erchivox/Prometheus-Team-2025/other/EncajeRuedaOneShape2026.jpeg

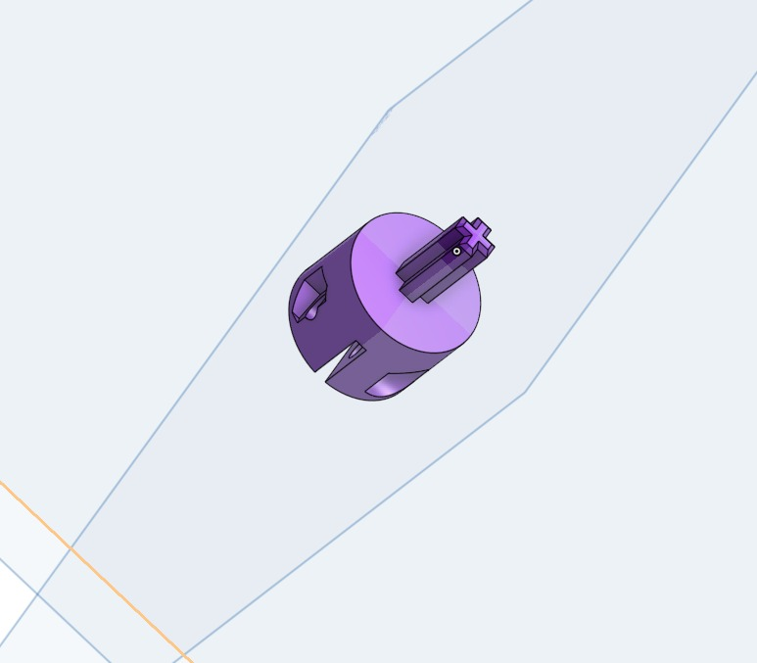
other/EncajeRuedaOneShape2026.jpeg
