erchivox/Prometheus-Team-2025/other/encajeSoporteTlfnOneShape2026.jpeg

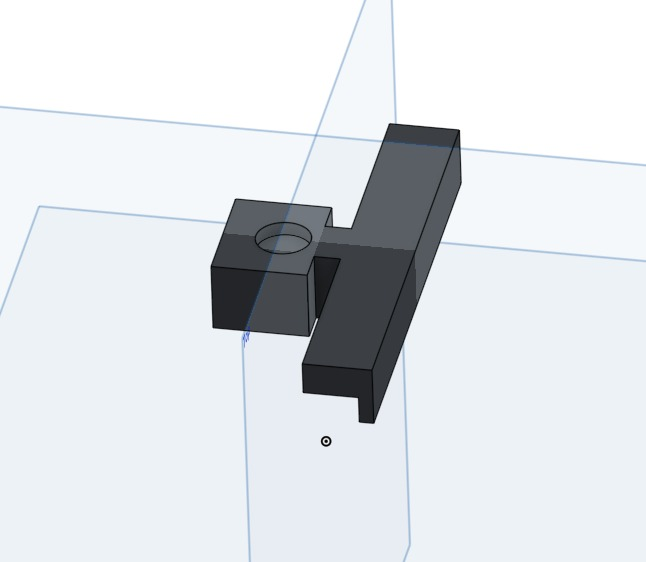
other/encajeSoporteTlfnOneShape2026.jpeg
