erchivox/Prometheus-Team-2025/other/engranajeMotorOneShape2026.jpeg

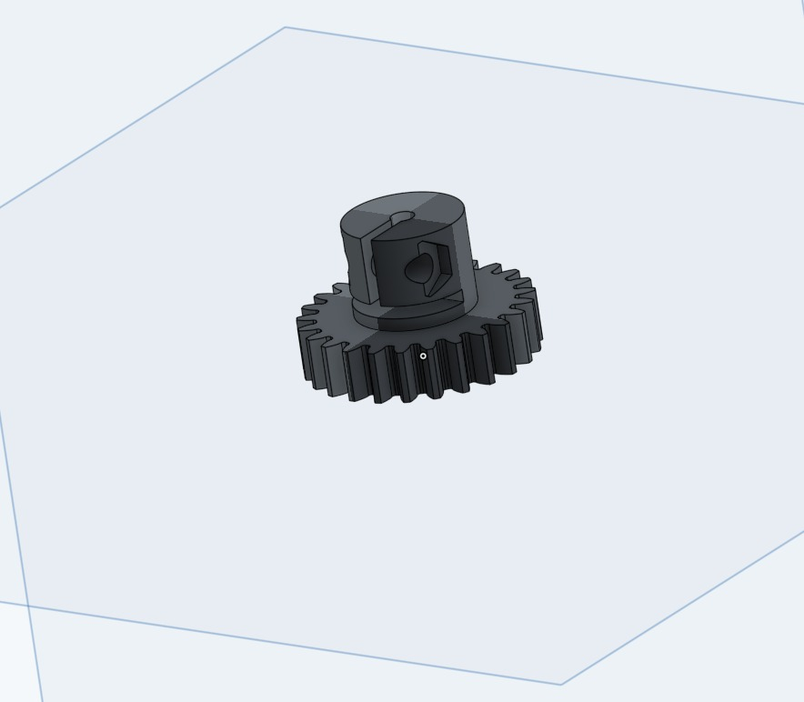
other/engranajeMotorOneShape2026.jpeg
