erchivox/Prometheus-Team-2025/other/engranajeVarillaOneShape2026.jpeg

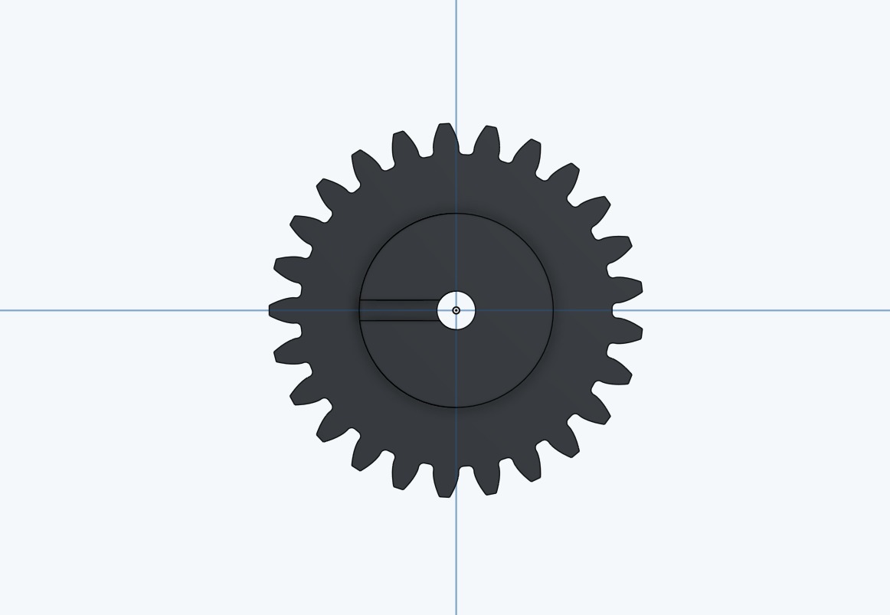
other/engranajeVarillaOneShape2026.jpeg
