erchivox/Prometheus-Team-2025/other/lateralSoporte2OneShape2026.jpeg

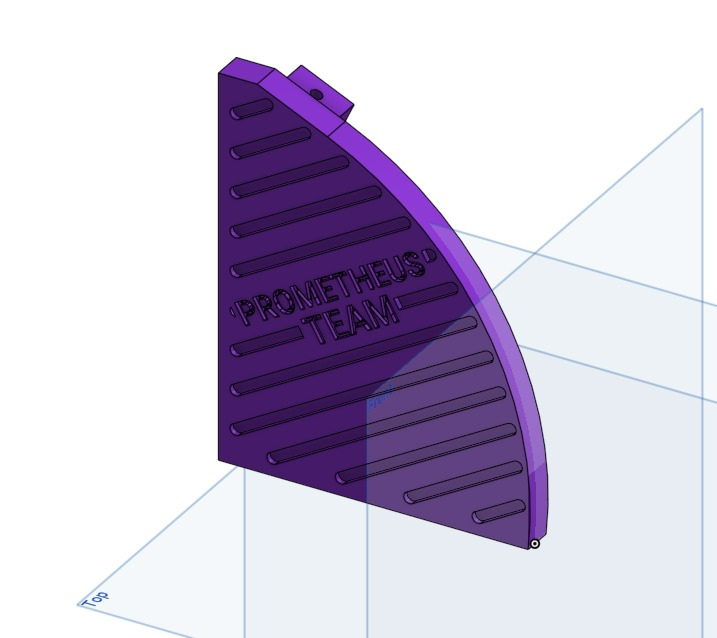
other/lateralSoporte2OneShape2026.jpeg
