erchivox/Prometheus-Team-2025/other/lateralSoporteTlfnOneShape2026.jpeg

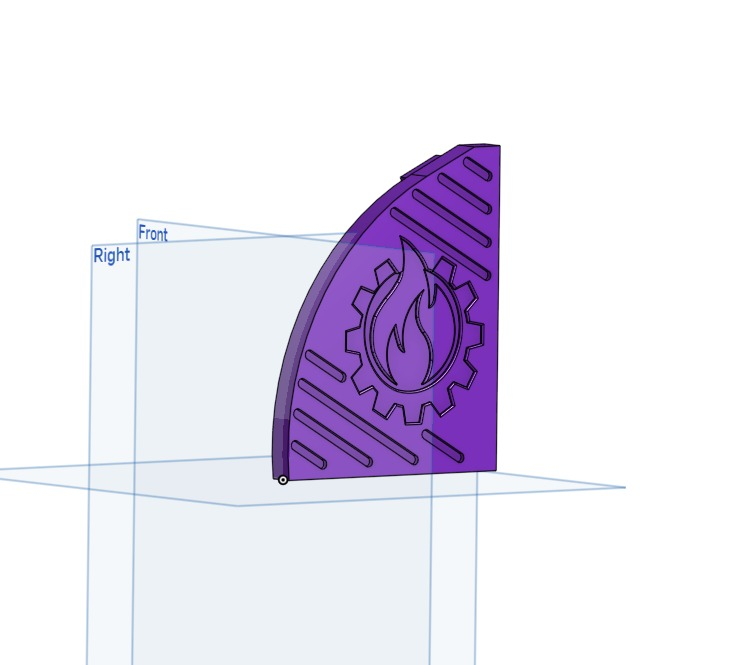
other/lateralSoporteTlfnOneShape2026.jpeg
