erchivox/Prometheus-Team-2025/other/motorConEngrenajesVistaCompletaOneShape2026.jpeg

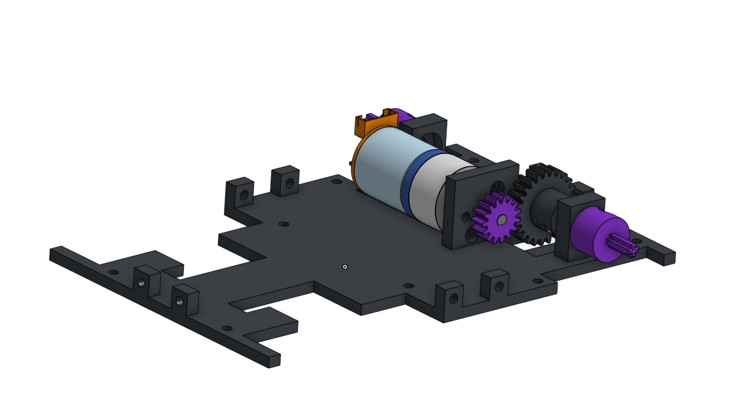
other/motorConEngrenajesVistaCompletaOneShape2026.jpeg
