erchivox/Prometheus-Team-2025/other/ShasisCompletoDiagonal2OneShape2026.jpeg

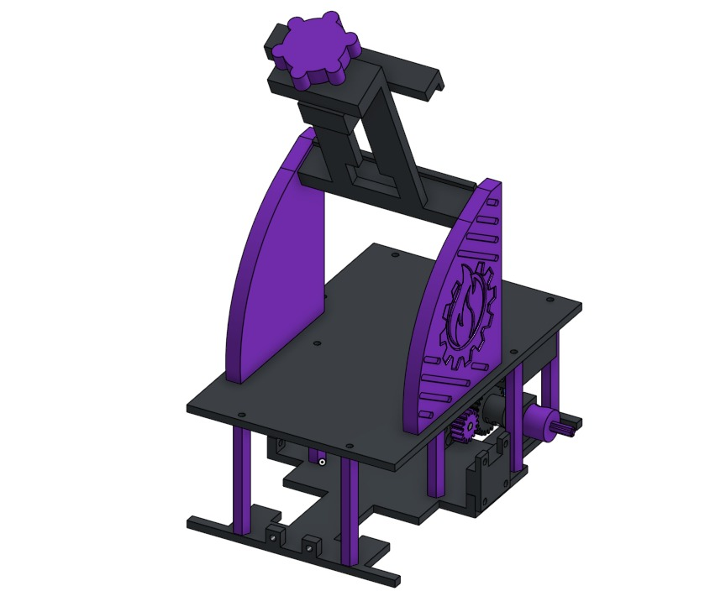
other/ShasisCompletoDiagonal2OneShape2026.jpeg
