erchivox/Prometheus-Team-2025/other/ShasisCompletodiagonalOneShape2026.jpeg

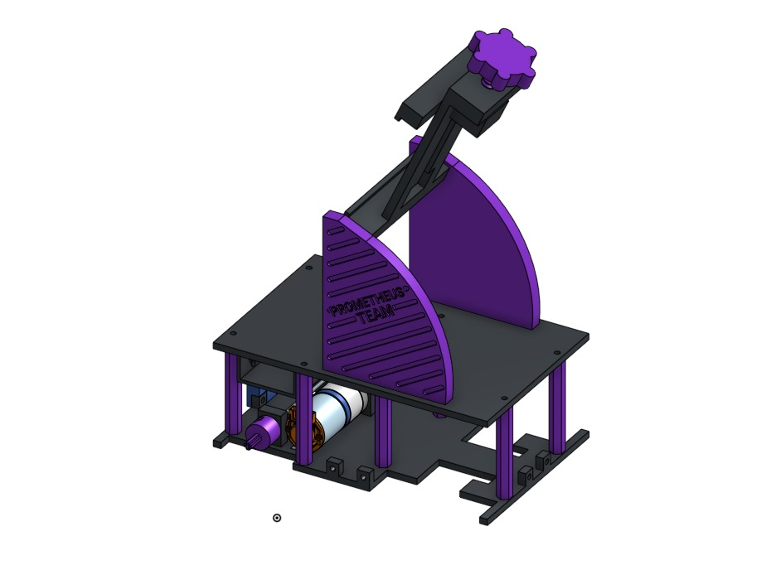
other/ShasisCompletodiagonalOneShape2026.jpeg
