erchivox/Prometheus-Team-2025/other/ShasisCompletoFrenteOneShape2026.jpeg

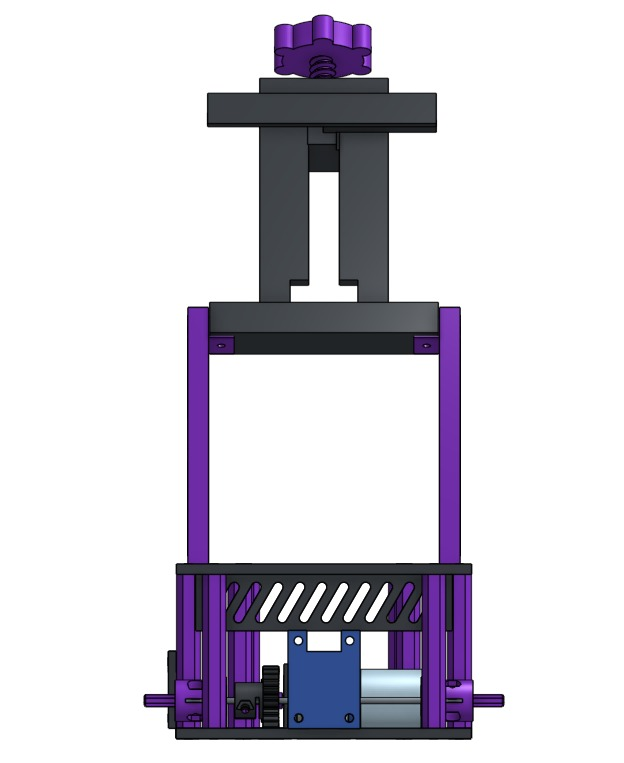
other/ShasisCompletoFrenteOneShape2026.jpeg
