erchivox/Prometheus-Team-2025/other/soporteSensorTofOneShape2026.jpeg

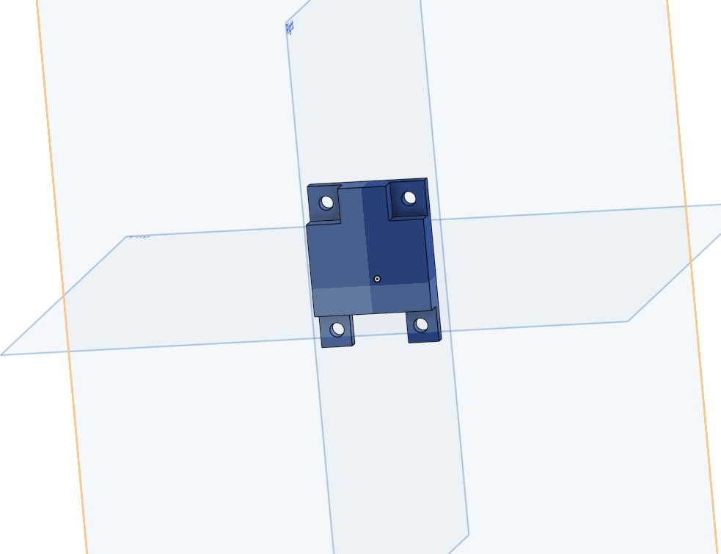
other/soporteSensorTofOneShape2026.jpeg
