erchivox/Prometheus-Team-2025/other/soporteTlfnOneShape2026.jpeg

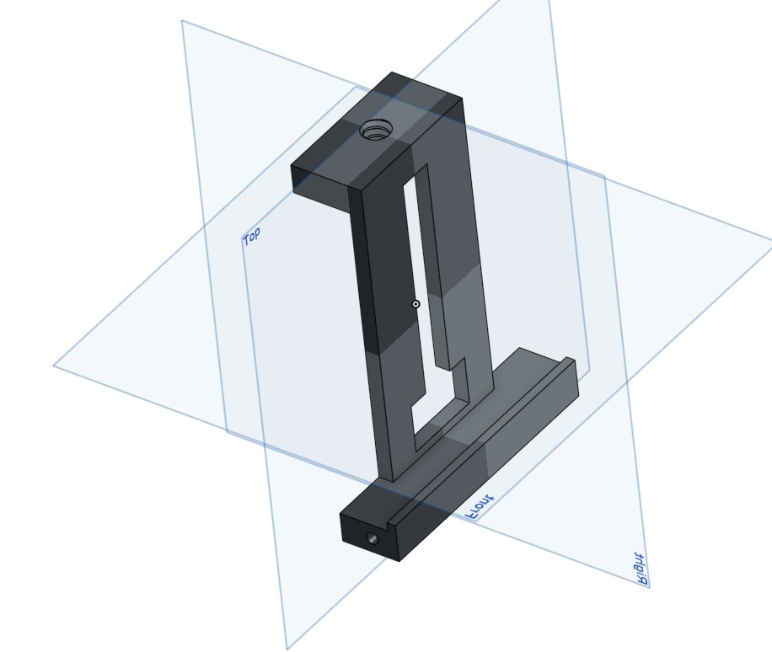
other/soporteTlfnOneShape2026.jpeg
