erchivox/Prometheus-Team-2025/other/soporteVarillaOneShape2026.jpeg

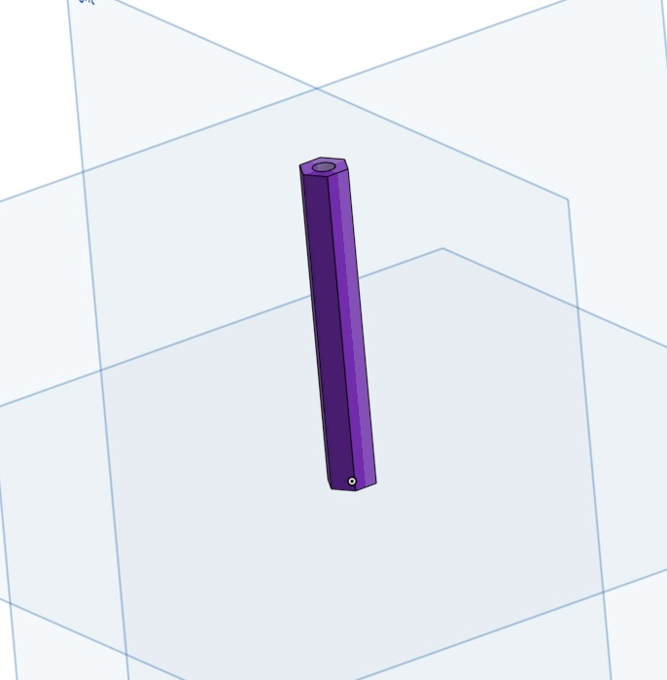
other/soporteVarillaOneShape2026.jpeg
