erchivox/Prometheus-Team-2025/other/tornilloTlfnOneShape2026.jpeg

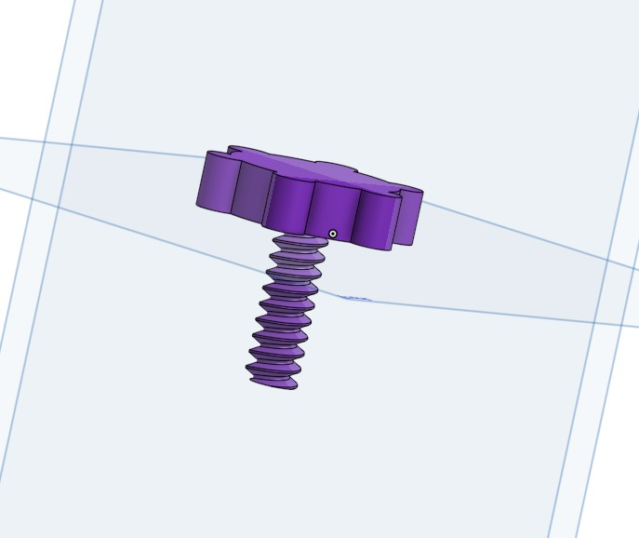
other/tornilloTlfnOneShape2026.jpeg
