erchivox/Prometheus-Team-2025/v-photos/ABAJO2026.jpeg

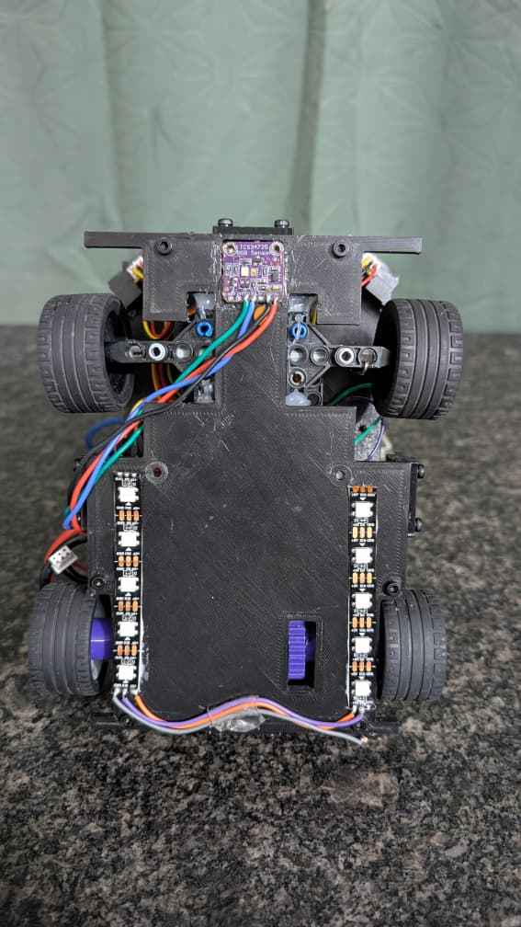
v-photos/ABAJO2026.jpeg
