erchivox/Prometheus-Team-2025/v-photos/ADELANTE2026.jpeg

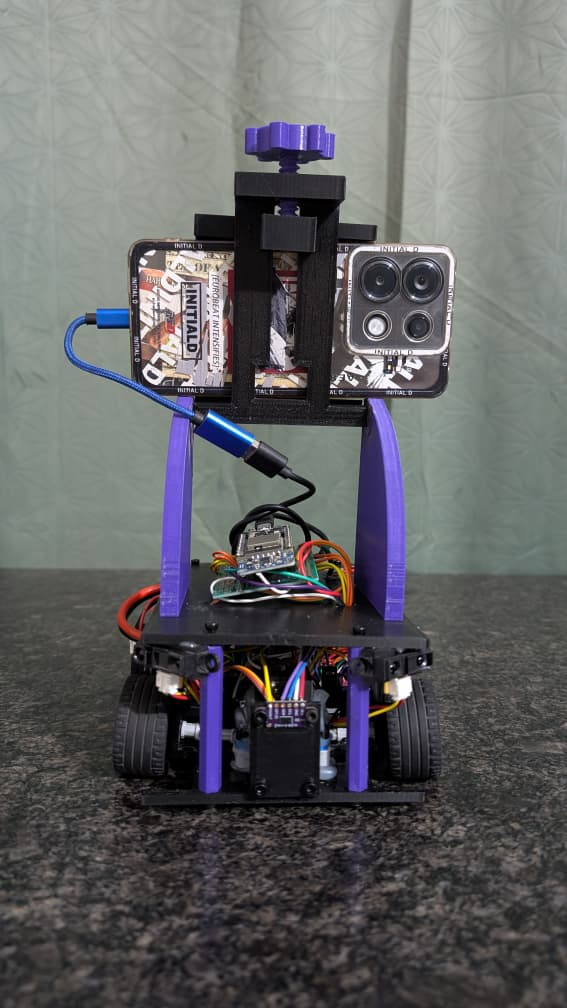
v-photos/ADELANTE2026.jpeg
