erchivox/Prometheus-Team-2025/v-photos/ARRIBA2026.jpeg

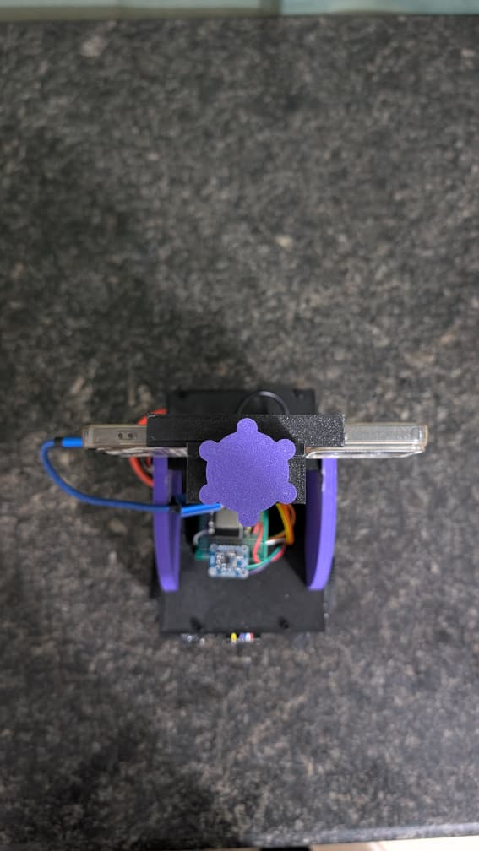
v-photos/ARRIBA2026.jpeg
