erchivox/Prometheus-Team-2025/v-photos/DERECHA2026.jpeg

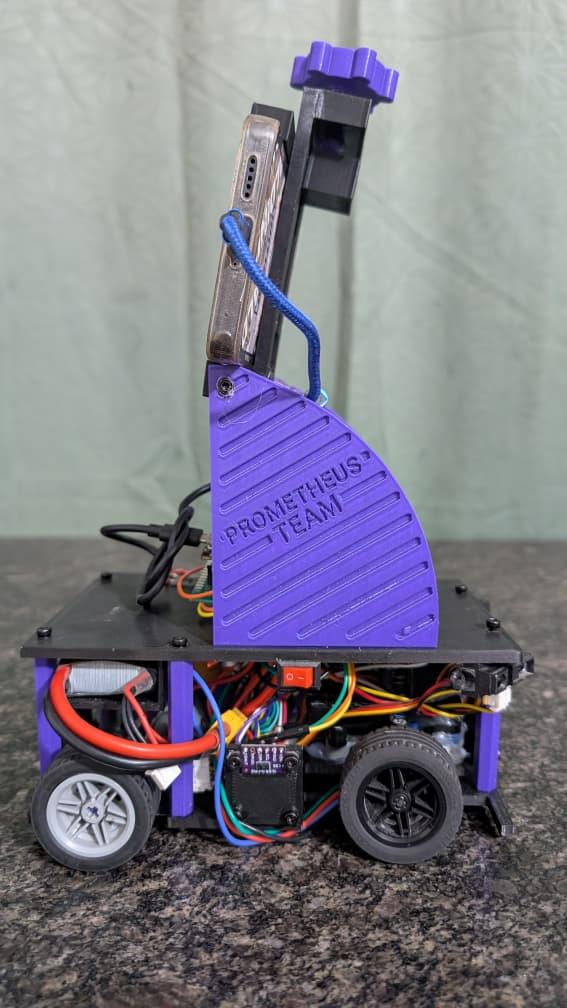
v-photos/DERECHA2026.jpeg
