erchivox/Prometheus-Team-2025/v-photos/DETRAS2026.jpeg

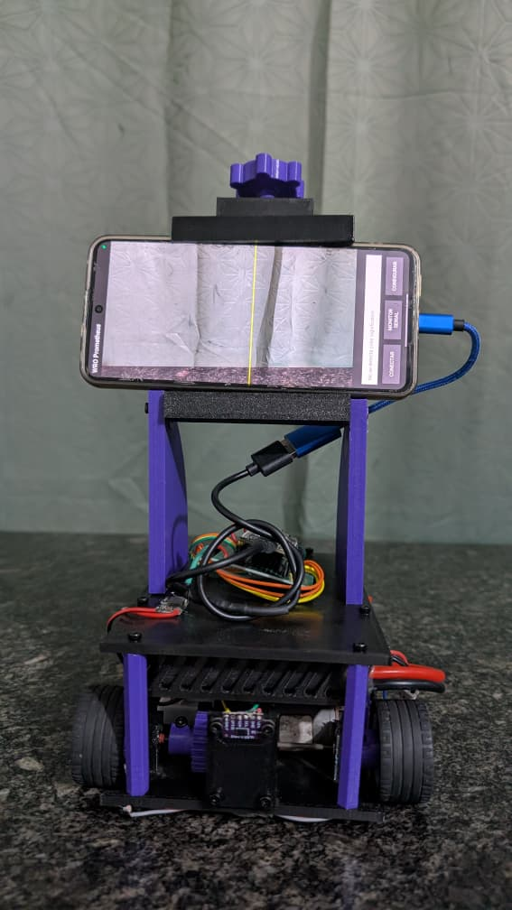
v-photos/DETRAS2026.jpeg
