erchivox/Prometheus-Team-2025/v-photos/IZQUIERDA2026.jpeg

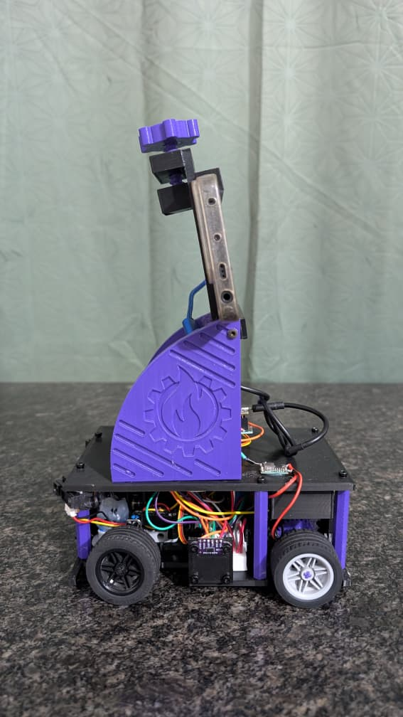
v-photos/IZQUIERDA2026.jpeg
