erchivox/Prometheus-Team-2025/src/v2PrometrusTeam2026.ino

//acuerdate que este codigo tiene 4 segundos para deteccion de una nueva linea
// advertencia : toma 2 tasas de cafe, guarda una copia de seguridad y cuidate del bug que solo pasa a las 
// 12pm, de resto suerte. 
#include <Wire.h>
#include <Adafruit_TCS34725.h>
#include <Adafruit_BNO055.h>

#include <ESP32Servo.h>
#include <ColorConverterLib.h>
#include <Adafruit_VL53L0X.h>
#include <Adafruit_Sensor.h>
#include <Adafruit_NeoPixel.h>

// --- Configuración de NeoPixels ---
#define NEOPIXEL_PIN 14   // ¡CÁMBIALO al pin de datos que vayas a usar!
#define NUMPIXELS 10       // ¡CÁMBIALO a la cantidad exacta de LEDs que tenga tu tira/módulo!

// Crear el objeto de la tira LED
Adafruit_NeoPixel tiraLED(NUMPIXELS, NEOPIXEL_PIN, NEO_GRB + NEO_KHZ800);

// --- Pines XSHUT para ToF ---
#define XSHUT_FRONTAL 17
#define XSHUT_TRASERO 16
#define XSHUT_IZQ     5
#define XSHUT_DER     18

Adafruit_TCS34725 tcs = Adafruit_TCS34725(TCS34725_INTEGRATIONTIME_2_4MS, TCS34725_GAIN_1X);
Adafruit_BNO055 bno = Adafruit_BNO055(55, 0x28, &Wire);
Servo direccion;

#define I2C2_SDA 32
#define I2C2_SCL 33
TwoWire I2CSegundo = TwoWire(1);

// --- Direcciones I2C ToF ---
#define ADDR_FRONTAL 0x30
#define ADDR_TRASERO 0x31
#define ADDR_IZQ     0x32
#define ADDR_DER     0x33

// --- Objetos ---
Adafruit_VL53L0X tofF = Adafruit_VL53L0X();
Adafruit_VL53L0X tofT = Adafruit_VL53L0X();
Adafruit_VL53L0X tofI = Adafruit_VL53L0X();
Adafruit_VL53L0X tofD = Adafruit_VL53L0X();

// --- Variables BNO055 ---
float yaw_offset = 0.0f;

// --- Configuración de Pines del Motor (Puente H) ---
const int MOTOR_IN1 = 27; // ¡Corregido! Estaba en conflicto con el pin 27 del interruptor
const int MOTOR_IN2 = 26; // Pin de dirección
const int MOTOR_ENA = 25; // Pin PWM para la velocidad

// --- Variables de Velocidad (rango de 0 a 255) ---
int velocidadBase = 255;      // Velocidad normal para avanzar
int velocidadRetroceso = 200; // Velocidad para echar hacia atrás
int velocidadLenta = 180;           // Velocidad reducida para avanzar 
int velocidadRetrocesoLento = 160;  // Velocidad reducida para retroceder

// --- Configuración de Canales PWM Independientes para ESP32 ---
const int canalMotor  = 4;
const int canalBuzzer = 5;
const int canalLED = 6;// Reservado por si quieres atenuar el LED luego

const int freqMotor = 1000;
const int resolucionPWM = 8;  // Resolución de 8 bits (0-255)

//const int MOTOR_RETROCESO_PIN = 19;  // Pin para motor de retroceso
//const int MOTOR_PIN = 15;
//const int MOTOR_RETROCESO_PIN_LENTO = 25;  // Pin para motor de retroceso
//const int MOTOR_PIN_LENTO = 26;
const int SERVO_PIN = 13;
// Declaraciones de pines (usar pines analógicos como digitales)
#define BUZZER_PIN  4  // Pin analógico A1 usado como digital para buzzer

// esta línea cerca del inicio del archivo, con las otras variables globales
bool primerGiroRealizado = false; // Flag para controlar el primer giro especial

//******************** colores 
// Variables para la detección del color azul
const int HUE_AZUL_MIN = 185;
const int HUE_AZUL_MAX = 240;
const float SATURACION_AZUL_MIN = 0.57;//0.40;
const float VALOR_AZUL_MIN = 0.40;
const float VALOR_AZUL_MAX = 0.80;
const float PROPORCION_AZUL_MIN = 1.1;//1.66
const int CONFIRMAR_AZUL_TOLERANCIA = 1;
const int CONFIRMAR_AZUL_DELAY = 1;
  
// Variables para la detección del color naranja
const int HUE_NARANJA_MIN = 2;//8;
const int HUE_NARANJA_MAX = 45;
const float SATURACION_NARANJA_MIN = 0.53;//40;
const float VALOR_NARANJA_MIN = 0.35;
const float VALOR_NARANJA_MAX = 0.72;
const int CONFIRMAR_NARANJA_TOLERANCIA = 1;
const int CONFIRMAR_NARANJA_DELAY = 1;
//*****888*******************************


const int INTERRUPTOR_PIN = 23;  // Pin digital para el interruptor (usa pin con interrupt)

// Variables de estado del sistema
bool sistemaIniciado = false;
bool interruptorAnterior = false;
unsigned long tiempoDebounce = 0;
const unsigned long DEBOUNCE_DELAY = 50;

// ===== CONFIGURACIÓN DE SERVO =====
const int SERVO_RIGHT = 0;
const int SERVO_CENTER = 90;
const int SERVO_LEFT  = 180;

const int SERVO_OrientadoObjeto_LEFT = 130;
const int SERVO_OrientadoObjeto_RIGH = 50;

const int SERVO_CENTRADO = SERVO_CENTER;

int contadorEntradaEstadoFinal = 0;

// Contador de líneas
int contadorLineas = 0;
int limiteLineas = 12;

int16_t ax, ay, az, gx, gy, gz;

float anguloZ = 0.0;
float pitch = 0.0;          // Ángulo Pitch (inclinación adelante/atrás)
float roll = 0.0;           // Ángulo Roll (inclinación lateral)

float anguloObjetivoGlobal = 0.0; // angulo recto para el giro


  float distanciaDerecha= 0 ;
    float distanciaIzquierda = 0 ;

const unsigned long TIEMPO_RETROCESO_MAXIMO = 1000;      // 1000Mayor tiempo para el giro más cerrado
const unsigned long TIEMPO_RETROCESO_ALTO = 0;        // 800Tiempo intermdio
const unsigned long TIEMPO_RETROCESO_MEDIO_ALTO = 0;  //600 Menor tiempo

// Ángulos de giro modificables para cada sentido
float giroObjetivoAzul = 70.0;    // Giro a la izquierda para línea azul
float giroObjetivoNaranja = 70.0; // Giro a la derecha para línea naranja (modificable)

float offsetGz = 0.0;
float offsetGx = 0.0; // Offset del giroscopio en X (Roll)
float offsetGy = 0.0; // Offset del giroscopio en Y (Pitch)

float umbralGiro = 1.0;
float umbralReposo = 0.5;
// Control de tiempo
unsigned long lastYawPrint = 0;
const unsigned long YAW_INTERVAL = 300;

unsigned long lastTime, startTime, timeoutGiro = 2000;


// ===== VARIABLES DE CONTROL DE DIRECCIÓN =====
bool corrigiendo = false;           // Estado de corrección activa
unsigned long tiempoInicioCorreccion = 0;
const unsigned long TIEMPO_MAX_CORRECCION = 6000; // 3 segundos máximo corrigiendo
const unsigned long TIEMPO_AVANCE_REINTENTO = 400; // 400ms de avance para reintentar
const unsigned long TIEMPO_ESTABILIZACION = 200;  // 200ms para estabilizar antes de verificar

float anguloObjetivo = 0.0;         // Ángulo objetivo dinámico
const float TOLERANCIA_ANGULO = 5.0; //4 antes Tolerancia de ±15° para considerar "recto"
const float TOLERANCIA_ANGULO_CORRECCION_LINEA_ANTES_DEL_GIRO = 15.0;
// ===== ESTADOS DE CORRECCIÓN =====
enum EstadoCorreccion {
  RECTO,                  // Vehículo va recto (0° ± margen)
  CORRIGIENDO_IZQUIERDA,  // Corrigiendo hacia la izquierda
  CORRIGIENDO_DERECHA,    // Corrigiendo hacia la derecha
  ESTABILIZANDO           // Estabilizando después de corrección
};

EstadoCorreccion estadoActualCorreccion = RECTO;
bool correccionCompletada = false;  // Flag para indicar que la corrección terminó

// Variables para control de centrado
bool enGiro = false;
unsigned long tiempoFinGiro = 0;
const unsigned long tiempoEsperaPosgiro = 0;
const int anguloCorreccionMax = 50;
const unsigned long intervaloCentrado = 100;
unsigned long ultimoTiempoCentrado = 0;

// Variables para pausar centrado durante detección
bool pausarCentrado = false;
unsigned long tiempoInicioDeteccion = 0;
const unsigned long tiempoPausaCentrado = 100;

// Variables para detección de líneas
bool lineaNaranjaDetectada = false;
unsigned long tiempoUltimaDeteccion = 0;
//tiempo de espera para deteccion de linea correcta, tambien se activa cuando inicia girando a carril.
const unsigned long tiempoEsperaDeteccion = 5000;//4000

// Flag para forzar tiempo de giro a 500ms al evadir obstáculo frontal
//Flag para controlar el inicio del cooldown tras un comando de carril
//bool iniciarCooldownCarril = false;

// Variables para direccionalidad
enum SentidoGiro {
  INDEFINIDO,
  IZQUIERDA,  // Detectó azul primero
  DERECHA     // Detectó naranja primero
};

SentidoGiro sentidoVehiculo = INDEFINIDO;
bool primeraDeteccion = true;

// ==================== VARIABLES PID PARA GIROS ====================

// Variables para controlador PID de giros
struct PIDController {
  float kp;           // Ganancia proporcional
  float ki;           // Ganancia integral
  float kd;           // Ganancia derivativa
  float error_anterior;
  float integral;
  float integral_max; // Límite para evitar windup
  unsigned long tiempo_anterior;
};

// Configuración del PID para giros
PIDController pidGiro = {
  .kp = 2.5,          // Ganancia proporcional - ajusta respuesta principal
  .ki = 0.8,          // Ganancia integral - elimina error en estado estacionario
  .kd = 0.4,          // Ganancia derivativa - reduce oscilaciones
  .error_anterior = 0,
  .integral = 0,
  .integral_max = 30, // Límite para integral windup
  .tiempo_anterior = 0
};

// Variables adicionales para control PID
float anguloObjetivoActual = 0;
bool giroEnProceso = false;
const float TOLERANCIA_PID = 5.0;      // Tolerancia más estricta con PID

// ==================== VARIABLES PID PARA CENTRADO ====================

// Variables para controlador PID de centrado
struct PIDCentrado {
  float kp;           // Ganancia proporcional
  float ki;           // Ganancia integral  
  float kd;           // Ganancia derivativa
  float error_anterior;
  float integral;
  float integral_max; // Límite para evitar windup
  unsigned long tiempo_anterior;
  bool inicializado;  // Para manejar primera ejecución
};

// Configuración del PID para centrado
PIDCentrado pidCentrado = {
  .kp = 2.0,          // Ganancia proporcional - respuesta principal al error
  .ki = 0.0,          // Ganancia integral - elimina error residual
  .kd = 1.2,          // Ganancia derivativa - reduce oscilaciones
  .error_anterior = 0,
  .integral = 0,
  .integral_max = 20, // Límite para integral windup
  .tiempo_anterior = 0,
  .inicializado = false
};

// Variables adicionales para control PID del centrado
const float TOLERANCIA_CENTRADO_PID = 5.0;    // Tolerancia más estricta
const float ERROR_MAXIMO_CENTRADO = 30.0;     // Error máximo esperado
const float FACTOR_SUAVIZADO = 0.7;           // Para suavizar cambios bruscos

// Buffer para comandos serie
String comandoRecibido = "";
  bool comandoListo = false;

// Pines para sensores de estacionamiento (el frontal ya está definido)
const int ULTRASONIDO_TRASERO_TRIG_PIN  = 18; // Pin para Trig del sensor ultrasónico trasero
const int ULTRASONIDO_TRASERO_ECHO_PIN = 35; // Pin para Echo del sensor ultrasónico trasero

//-------variables de evasion de objetos--------------

// Estados del sistema integrado
enum EstadoSistema {
  ESTADO_NORMAL,
  ESTADO_DETENCION_FINAL,
  ESPERANDO_COMANDO_CARRIL,
  EVALUANDO_POSICION,
  GIRANDO_HACIA_CARRIL,
  ENDEREZANDO_CARRIL,
  MANTENIENDO_CARRIL,
  ESTADO_CORRECCION_LATERAL 
};

// Variables para recepción serial optimizada (del código de esquive)
const int BUFFER_SIZE = 32;
char buffer[BUFFER_SIZE];
int bufferIndex = 0;

// Variables para parsing ultra rápido
char colorDetectado = 'N';
int distanciaObjeto = 0;
char orientacionObjeto = 'C';

// Variables de estado
EstadoSistema estadoActual = ESPERANDO_COMANDO_CARRIL;
char colorObjetivo = 'N';
unsigned long tiempoEsquive = 0;
int etapaEsquive = 0;
char lastOrientation = 'X';

// Configuración de distancias para esquive
const int DISTANCIA_ROJO = 35;//40;    // Distancia de esquive para objetos rojos
const int DISTANCIA_VERDE = 40;//45;   // Distancia de esquive para objetos verdes
const int DISTANCIA_EMERGENCIA = 8;
// Tiempos de esquive por color (en milisegundos)
const unsigned long TIEMPO_ESQUIVE_VERDE = 600;   // Tiempo para esquivar verde
const unsigned long TIEMPO_ESQUIVE_ROJO = 400;   // Tiempo para esquivar rojo
const unsigned long TIEMPO_RETORNO_VERDE = 600;   // Tiempo de retorno para verde
const unsigned long TIEMPO_RETORNO_ROJO = 600;    // Tiempo de retorno para rojo

// Variables para almacenar los tiempos actuales
unsigned long tiempoEsquiveActual = 0;
unsigned long tiempoRetornoActual = 0;

// Variables para recordar último color detectado
char ultimoColorDetectado = 'N';           // Último color válido recibido
unsigned long tiempoUltimoColor = 0;       // Timestamp del último color detectado
const unsigned long TIEMPO_MEMORIA_COLOR = 0; // 4 segundos de memoria

// Variables para función de emergencia
bool emergenciaActivada = false;
unsigned long tiempoUltimaEmergencia = 0;
const unsigned long TIEMPO_ESPERA_EMERGENCIA = 2000; // Evitar activaciones múltiples
char colorEmergencia = 'N';

// Variables para interrupción de cruce
volatile bool interrupcionCruce = false;
volatile char comandoInterrupcion = 'N';
bool cruceEnProceso = false;
//------------------- Fin de variables de esquive--------------

// ==================== CONFIGURACIÓN Y VARIABLES SHARP ====================

// Pines para sensores Sharp diagonales
const int SHARP_DIAGONAL_IZQ_PIN = 35;  // Pin analógico para sensor Sharp izquierdo
const int SHARP_DIAGONAL_DER_PIN = 34;  // Pin analógico para sensor Sharp derecho

const float DISTANCIA_EMERGENCIA_SHARP_PARED = 13.0; // Distancia en cm para activar el retroceso de emergencia
const unsigned long TIEMPO_RETROCESO_SHARP_PARED = 700;  //800 Tiempo de retroceso en ms (ajustable)

 //CONSTANTES PARA CORRECCIÓN EN PARED *****
const float DISTANCIA_MINIMA_SHARP_PARED = 12.0; // Distancia en cm para activar la corrección
const int ANGULO_CORRECCION_SHARP_IZQ = 180;     // Ángulo para girar a la izquierda (alejarse de la pared derecha)
const int ANGULO_CORRECCION_SHARP_DER = 0;      // Ángulo para girar a la derecha (alejarse de la pared izquierda)
unsigned long tiempoUltimaEmergenciaSharpDer = 0;
unsigned long tiempoUltimaEmergenciaSharpIzq = 0;
const unsigned long COOLDOWN_EMERGENCIA_SHARP = 2000; // 3 segundos para considerar una detección como "reciente"
const unsigned long DURACION_AVANCE_CORRECTIVO = 800; // 400ms de avance

// Variables para esquive diagonal por sensores Sharp
bool esquiveDiagonalActivo = false;
unsigned long tiempoInicioEsquiveDiagonal = 0;
unsigned long tiempoUltimaDeteccionSharp = 0;
char direccionEsquiveDiagonal = 'N'; // 'I' = izquierda, 'D' = derecha
int etapaEsquiveDiagonal = 0;

// Configuración para sensores Sharp diagonales
const float DISTANCIA_SHARP_EMERGENCIA = 15.0;     // 10cm de detección
const unsigned long TIEMPO_CRUCE_DIAGONAL = 500;  // Tiempo de cruce diagonal
const unsigned long TIEMPO_ESPERA_SHARP = 100;     // Evitar detecciones múltiples

// Sistema de prioridades para gestión de emergencias
enum PrioridadEmergencia {
  PRIORIDAD_NORMAL,
  PRIORIDAD_RETROCESO,  // Máxima prioridad
  PRIORIDAD_ESQUIVE     // Prioridad normal
};
PrioridadEmergencia prioridadActual = PRIORIDAD_NORMAL;

// Variables mejoradas para retroceso de emergencia
const int DISTANCIA_RETROCESO_EMERGENCIA = 10;    // Distancia mínima para activar retroceso (cm)
const unsigned long TIEMPO_RETROCESO = 2000;     // Tiempo de retroceso en ms
const unsigned long TIMEOUT_RETROCESO = 2500;    // Timeout de seguridad para retroceso
bool retrocesoPorEmergencia = false;    
// Variables de control temporal
unsigned long tiempoInicioRetroceso = 0;          
unsigned long tiempoUltimaVerificacionRetroceso = 0; 
const unsigned long INTERVALO_VERIFICACION_RETROCESO = 100; // Verificación cada 100ms
const unsigned long TIEMPO_ESPERA_POST_RETROCESO = 100;     // Tiempo de espera después del retroceso
bool motorRetrocesoConfigurado = false;  // controlar configuración de motores

bool retrocesoOrientadoActivo = false;
bool enFaseContragiro = false; // true cuando está ejecutando el contragiro de enderezado
bool omitioGiro = false; // true cuando saltó directo a MANTENIENDO sin hacer giro
unsigned long tiempoInicioRetrocesoOrientado = 0;
const unsigned long TIEMPO_RETROCESO_ORIENTADO = 700; // 1 segundo (modificable)
int direccionRetroceso = SERVO_CENTRADO;

// ==================== ESTRUCTURA DE CONTROL LATERAL ====================
struct ControlDistanciaLateral {
  enum Estado {
    IDLE,
    MOVIENDO_DERECHA,
    MOVIENDO_IZQUIERDA,
    CORRIGIENDO_ANGULO_DERECHA,
    CORRIGIENDO_ANGULO_IZQUIERDA,
    RETROCEDIENDO_ORIENTADO,     
    CORRIGIENDO_POST_RETROCESO,   
    RETROCEDIENDO_FINAL
    };     
  Estado estadoActual = IDLE;
  unsigned long tiempoInicioEstado = 0;
  float anguloObjetivo = 0.0;
  bool funcionActiva = false; 
  unsigned long ultimaVerificacion = 0;
  bool esCorreccionLarga = false; //  Flag para saber qué maniobra ejecutar
  char direccionManiobra = 'N';   // 'D' o 'I' para recordar la dirección

  // Parámetros de control
  const float UMBRAL_MIN = 30.0;//38
  const float UMBRAL_MAX = 55.0; 
  unsigned long tiempoCruceActual = 1000;
  
  const float DISTANCIA_TRASERA_OBJETIVO = 15.0; // cm
  const float TOLERANCIA_ANGULAR = 2.0; 
  const unsigned long INTERVALO_VERIFICACION = 1000;
};

ControlDistanciaLateral controlLateral_PostGiro; // Usamos un nuevo nombre para no confundir con el existente

// Variables para control de retroceso post-giro
unsigned long tiempoInicioEvaluacion = 0;
// ============== CONSTANTES DE ÁNGULOS ==============
const float GIRO_MAXIMO = 70.0;      // Giro máximo - obstáculo muy cerca
const float GIRO_ALTO = 60.0;        // Giro alto - obstáculo cerca
const float GIRO_MEDIO_ALTO = 50.0;  // Giro medio-alto
const float GIRO_MEDIO = 50.0;       // Giro medio
const float GIRO_MEDIO_BAJO = 50.0;  // Giro medio-bajo
const float GIRO_BAJO = 50.0;        // Giro bajo - obstáculo lejano
const float GIRO_MINIMO = 60.0;//30.0 Giro mínimo - obstáculo muy lejano
float anguloObjetivoGiroGlobal = 0;
// Variable para distancia mínima para terminar el retroceso post giro
float DISTANCIA_MINIMA_RETROCESO = 15.0; // 15cm
const unsigned long TIMEOUT_RETROCESO_MAXIMO = 4000;    // Timeout de seguridad de retroceso orientado
// Variable global para medir tiempo de retroceso durante corrección
unsigned long tiempoTotalRetroceso = 0;
bool huboRetrocesoEnCorreccion = false;

// Variables para el giro de apertura
bool giroAperturaActivo = false;
bool giroAperturaCompletado = false;
unsigned long tiempoInicioApertura = 0;
const unsigned long DURACION_APERTURA_MINIMO = 200;//500     // Tiempo para el giro más suave
const unsigned long DURACION_APERTURA_BAJO = 0;   //200    // tiempo, más corto
const unsigned long DURACION_APERTURA_MEDIO_BAJO = 0; //  tiempo, el más corto
bool esGiroApertura = false;
unsigned long duracionAperturaActual = DURACION_APERTURA_MINIMO; // Variable para almacenar la duración del giro actualbool esGiroApertura = false;
bool direccionGiroAperturaIzquierda = false;

bool sistemaActivo = false;  // Estado del sistema (activo/inactivo)

// Variable para controlar giro antes de estacionamiento
bool giroParaEstacionamiento = false;

// tiempo de finalizacion del codigo para avance final
unsigned long tiempoInicio = millis();
//unsigned long duracionCiclo = 3000; // 5 segundos en milisegundos

unsigned long tiempoInicioDetencionFinal = 0;


// Variables globales para el control de arranque del motor
unsigned long tiempoInicioSistema = 0;
bool motorArrancado = false;
const unsigned long DELAY_ARRANQUE_MOTOR = 1000; // 1 segundo en milisegundos

static unsigned long tiempoInicioAvance = 0;

// Variable para pausa de prueba (configurable)
static unsigned long tiempoInicioPausa = 0;

// Configuración para control angular prioritario
#define UMBRAL_ANGULO_MAX 15.0      // Umbral máximo de desviación angular (±20°)
#define TOLERANCIA_ANGULO_FINO 2.0  // Tolerancia para considerar ángulo correcto
#define FACTOR_CORRECCION_ANGULAR 0.8  // Factor fuerte para corrección angular
#define FACTOR_CORRECCION_DISTANCIA 0.3  // Factor menor para distancia cuando hay error angular


// ==================== CONFIGURACIÓN DEL SISTEMA DE CARRILES ====================
struct SistemaCarriles {
  // Definición de carriles
  float distanciaCarril1;
  float distanciaCarril2;  
  float toleranciaCarril;
  float umbralCambio;
  
  // Parámetros de control
  float velocidadGiro;
  unsigned long tiempoGiro;
  unsigned long tiempoGiroCarril1;
  unsigned long tiempoGiroCarril2;
  float toleranciaAngulo;
  
  // Variables de control
  int carrilObjetivo;
  char ladoControl;
  unsigned long tiempoInicioEstado;
  float direccionGiro;
  bool necesitaCambio;
  bool esComandoC21;
  bool esComandoC14; 
  bool esComandoC15;
  bool esComandoC20;
  bool esComandoC26; 
  bool esComandoC33;
  bool esComandoC27;
  bool esComandoC32;

  bool esComandoC36;

  //individuales
  bool esComandoC02;
  bool esComandoC08;

  bool esComandoC07;
  bool esComandoC01;
    bool esComandoC01ModoDistancia; // C01 con sentido IZQUIERDA: tiempo de giro variable por ToF derecho
    bool esComandoC07ModoDistancia;
    bool esComandoC02ModoDistancia;
    bool esComandoC08ModoDistancia;
  
};

SistemaCarriles carriles = {
  .distanciaCarril1 = 20.0,
  .distanciaCarril2 = 20.0,
  .toleranciaCarril = 3.0,
  .umbralCambio = 1.0,
  .velocidadGiro = 45.0,
  .tiempoGiro = 1500,
  .tiempoGiroCarril1 = 1400,//1800
  .tiempoGiroCarril2 = 1300,//1500
  .toleranciaAngulo = 5.0,
  .carrilObjetivo = 0,
  .ladoControl = 'D',
  .tiempoInicioEstado = 0,
  .direccionGiro = 0,
  .necesitaCambio = false,
  .esComandoC21 = false,
  .esComandoC14 = false,
  .esComandoC15 = false,
  .esComandoC20 = false,
  .esComandoC26 = false,
  .esComandoC33 = false,
  .esComandoC27 = false,
  .esComandoC32 = false,
  .esComandoC36 = false,

  //individuales
  .esComandoC02 = false,
  .esComandoC08 = false,

  .esComandoC07 = false,
  .esComandoC01 = false,
    .esComandoC01ModoDistancia = false,
    .esComandoC07ModoDistancia = false,
    .esComandoC02ModoDistancia = false,
    .esComandoC08ModoDistancia = false


  
};
int ultimoCarrilActivo = 0; 
// Variables de tiempo y monitoreo de carriles
unsigned long ultimaActualizacion = 0;
const unsigned long INTERVALO_CONTROL = 50;
unsigned long ultimoReporte = 0;
const unsigned long INTERVALO_REPORTE = 300;


const unsigned long INTERVALO_maxAngulo = 500;  // 2000 ms = 2 segundos

unsigned long ultimaImpresion_maxAngulo = 0;

// Estructura para el control lateral
struct FiltroDistancia {
  float historial[5];
  int indice;
  bool inicializado;
  float ultimaDistanciaValida;
  float umbralCambioMaximo;
  
  void inicializar() {
    for (int i = 0; i < 5; i++) historial[i] = 0;
    indice = 0;
    inicializado = false;
    ultimaDistanciaValida = 0;
    umbralCambioMaximo = 50.0;
  }
  
  float filtrar(float nuevaLectura) {
    if (nuevaLectura <= 0 || nuevaLectura > 150) {
      return ultimaDistanciaValida;
    }
    if (!inicializado || abs(nuevaLectura - ultimaDistanciaValida) <= umbralCambioMaximo) {
      historial[indice] = nuevaLectura;
      indice = (indice + 1) % 5;
      if (!inicializado) {
        for (int i = 0; i < 5; i++) historial[i] = nuevaLectura;
        inicializado = true;
      }
      float suma = 0;
      for (int i = 0; i < 5; i++) suma += historial[i];
      ultimaDistanciaValida = suma / 5.0;
      return ultimaDistanciaValida;
    } else {
      return ultimaDistanciaValida;
    }
  }
};

struct ControlLateral {
  float distanciaObjetivo;
  float toleranciaDistancia;
  float toleranciaAngulo;
  float anguloObjetivo;
  float anguloUmbral;
  float kpDistancia, kiDistancia, kdDistancia;
  float correccionMaxima;
  float factorGiroIzquierda;
  float factorGiroDerecha; 
  float errorDistanciaAnterior;
  float integralDistancia;
  float integralMaxDistancia;
  char ladoControl;
  FiltroDistancia filtroIzquierda;
  FiltroDistancia filtroDerecha;
};

ControlLateral controlLateral = {
  .toleranciaDistancia = 3.0,
  .toleranciaAngulo = 3.0,//algulo aceptado como recto
  .anguloObjetivo = 0.0,
  .anguloUmbral = 20.0, //angulo de desviasion maxima para empezar correccion agresiva
  .kpDistancia = 4.0,
  .kiDistancia = 0.0,
  .kdDistancia = 1.2,
  .correccionMaxima = 40.0,
  .factorGiroIzquierda = 0.8,//1.0
  .factorGiroDerecha = 0.8,
  .errorDistanciaAnterior = 0,
  .integralDistancia = 0,
  .integralMaxDistancia = 20.0,
  .ladoControl = 'D'
};
unsigned long ultimaActualizacionf = 0;
const unsigned long INTERVALO_CONTROLf = 50;
unsigned long ultimoReportef = 0; // Añade esta línea
const unsigned long INTERVALO_REPORTEf = 300; // Añade esta línea (imprime ~3 veces/seg)

// --- Configuración de Tareas Multi-núcleo (FreeRTOS) ---

TaskHandle_t TareaColorHandle = NULL;



// ==================== TEMPORIZADOR NO BLOQUEANTE PARA LEDS ====================
unsigned long tiempoInicioLedTemporal = 0;
unsigned long duracionLedTemporal = 0;
bool ledTemporalActivo = false;

// Tiempo mínimo que el vehículo avanza en MANTENIENDO_CARRIL antes del cambio C21
const unsigned long TIEMPO_AVANCE_MANTENIENDO_C21 = 500; // ms — ajustable
const unsigned long TIEMPO_AVANCE_MANTENIENDO_C14 = 100; // ms — ajustable
const unsigned long TIEMPO_AVANCE_MANTENIENDO_C15 = 800; // ms — ajustable
const unsigned long TIEMPO_AVANCE_MANTENIENDO_C20 = 700; // ms — ajustable

const unsigned long TIEMPO_AVANCE_MANTENIENDO_C26 = 0; // rojo derecha, verde derecha

const unsigned long TIEMPO_AVANCE_MANTENIENDO_C27 = 500; // rojo derecha, verde derecha

const unsigned long TIEMPO_AVANCE_MANTENIENDO_C32 = 200; // rojo derecha, verde derecha
const unsigned long TIEMPO_AVANCE_MANTENIENDO_C33 = 200; // rojo derecha, verde derecha

// Función para lanzar un destello sin bloquear el código
void encenderLedTemporal(uint8_t r, uint8_t g, uint8_t b, unsigned long duracion) {
  colorVehiculo(r, g, b);
  tiempoInicioLedTemporal = millis();
  duracionLedTemporal = duracion;
  ledTemporalActivo = true;
}

// Función que vigila si ya es hora de apagar el destello
void actualizarLedTemporal() {
  if (ledTemporalActivo && (millis() - tiempoInicioLedTemporal >= duracionLedTemporal)) {
    // Si estamos en modo de espera, debe volver a morado. Si no, se apaga.
    if (estadoActual == ESPERANDO_COMANDO_CARRIL) {
      colorVehiculo(128, 0, 255); // Morado
    } else {
      apagarVehiculo();
    }
    ledTemporalActivo = false;
  }
}
// ==============================================================================
// ==================== CONTROL DE NEOPIXELS ====================
// Función para poner todos los LEDs del mismo color de golpe
void colorVehiculo(uint8_t r, uint8_t g, uint8_t b) {
  for(int i = 0; i < tiraLED.numPixels(); i++) {
    tiraLED.setPixelColor(i, tiraLED.Color(r, g, b));
  }
  tiraLED.show();
}

// Función para apagar los LEDs
void apagarVehiculo() {
  tiraLED.clear();
  tiraLED.show();
}
// ==============================================================

// Función independiente que se ejecuta continuamente en el Núcleo 0
void TareaDeteccionColor(void * pvParameters) {
  Serial.print(F("Control del sensor de color iniciado en el núcleo: "));
  Serial.println(xPortGetCoreID());

  while (1) {
    // Ejecuta la lectura del sensor solo si el interruptor activó el sistema
    if (sistemaActivo) {
      detectarColor();
    }
    

    vTaskDelay(pdMS_TO_TICKS(30)); 
  }
}

// ==================== FUNCIONES DE CONTROL DE MOTOR ====================
void detenerMotor() {
  digitalWrite(MOTOR_IN1, LOW);
  digitalWrite(MOTOR_IN2, LOW);
  ledcWrite(MOTOR_ENA, 0); // <-- Cambiado canalMotor por MOTOR_ENA
}

void avanzarMotor(int velocidad = velocidadBase) {
  digitalWrite(MOTOR_IN1, HIGH);
  digitalWrite(MOTOR_IN2, LOW);
  ledcWrite(MOTOR_ENA, velocidad); // <-- Cambiado canalMotor por MOTOR_ENA
}

void retrocederMotor(int velocidad = velocidadRetroceso) {
   digitalWrite(MOTOR_IN1, LOW);
  digitalWrite(MOTOR_IN2, HIGH); 
  ledcWrite(MOTOR_ENA, velocidad); // <-- Cambiado canalMotor por MOTOR_ENA
}


void avanzarLento() {
  // Reutiliza la lógica de avanzar, pero le inyecta la velocidad reducida
  avanzarMotor(velocidadLenta); 
}

void retrocederLento() {
  // Reutiliza la lógica de retroceder, pero le inyecta la velocidad reducida
  retrocederMotor(velocidadRetrocesoLento); 
}
// =======================================================================
float leerToF(char sensor) {
  VL53L0X_RangingMeasurementData_t measure;
  switch(sensor) {
    case 'F': tofF.rangingTest(&measure, false); break;
    case 'T': tofT.rangingTest(&measure, false); break;
    case 'I': tofI.rangingTest(&measure, false); break;
    case 'D': tofD.rangingTest(&measure, false); break;
    default: return 999.0;
  }
  if (measure.RangeStatus != 4) {
    return measure.RangeMilliMeter / 10.0;
  } else {
    return 999.0;
  }
}


// ==================== FUNCIONES DE CARRIL ====================
float obtenerDistanciaObjetivo() {
  if (carriles.carrilObjetivo == 1) {
    return carriles.distanciaCarril1;
  } else {
    return carriles.distanciaCarril2;
  }
}

char obtenerLadoControlPorCarril() {
  if (carriles.carrilObjetivo == 1) {
    return 'D';  // Carril 1 siempre usa sensor derecho
  } else {
    return 'I';  // Carril 2 siempre usa sensor izquierdo
  }
}

String obtenerNombreEstado(EstadoSistema estado) { // 1. Cambiado el tipo de parámetro
  switch (estado) {
    // Estados generales
    case ESTADO_NORMAL: return "ESTADO_NORMAL";
    case ESTADO_DETENCION_FINAL: return "ESTADO_DETENCION_FINAL";
    
    // Estados de carril (usando los nombres de EstadoSistema)
    case ESPERANDO_COMANDO_CARRIL: return "ESPERANDO_COMANDO_CARRIL";
    case EVALUANDO_POSICION: return "EVALUANDO_POSICION";
    case GIRANDO_HACIA_CARRIL: return "GIRANDO_HACIA_CARRIL";
    case ENDEREZANDO_CARRIL: return "ENDEREZANDO_CARRIL";
    case MANTENIENDO_CARRIL: return "MANTENIENDO_CARRIL";
    case ESTADO_CORRECCION_LATERAL: return "ESTADO_CORRECCION_LATERAL"; 
    
    default: return "DESCONOCIDO";
  }
}

void cambiarEstado(EstadoSistema nuevoEstado) { // 1. Cambiado el tipo de parámetro
  if (estadoActual != nuevoEstado) { // 2. Se usa la variable global estadoActual
    Serial.println("🔄 Cambio estado: " + obtenerNombreEstado(estadoActual) + 
                  " → " + obtenerNombreEstado(nuevoEstado));
    // ==========================================
    // Control de luz de estado Morada
    if (nuevoEstado == ESPERANDO_COMANDO_CARRIL) {
      colorVehiculo(128, 0, 255); // Morado
    } else {
      apagarVehiculo(); // Asegura que se apague al salir del estado
    }
    // ==========================================
    //*********
    // Si entramos en el estado de mantener carril, guardamos cuál es el carril activo.
    // Esta será nuestra "memoria" para cuando se detecte una línea.
    if (nuevoEstado == MANTENIENDO_CARRIL) {
      ultimoCarrilActivo = carriles.carrilObjetivo;
      Serial.println("✍️ Último carril activo actualizado a: " + String(ultimoCarrilActivo));
    }
    //******
    estadoActual = nuevoEstado; // 3. Se actualiza la variable global
    carriles.tiempoInicioEstado = millis();
    
    // Resetear variables de control del mantenimiento de pared
    controlLateral.integralDistancia = 0;
    controlLateral.errorDistanciaAnterior = 0;

    controlLateral.filtroIzquierda.inicializar();
    controlLateral.filtroDerecha.inicializar();
       // Reset flag C21 si se cambia manualmente de estado
    if (nuevoEstado == ESPERANDO_COMANDO_CARRIL) { // 4. Usar el nombre de EstadoSistema
      carriles.esComandoC21 = false;
      carriles.esComandoC14 = false;
      carriles.esComandoC15 = false;
      carriles.esComandoC20 = false; 
      carriles.esComandoC26 = false;
      carriles.esComandoC33 = false; 
      carriles.esComandoC27 = false; 
      carriles.esComandoC32 = false;
      carriles.esComandoC02 = false;
      carriles.esComandoC08 = false;
      carriles.esComandoC36 = false;
      carriles.esComandoC07 = false;
      carriles.esComandoC01 = false;
      omitioGiro = false; // Resetear flag al volver a esperar comando
      
      // Limpiar buffers de comunicación para asegurar que se espere un comando NUEVO.
      Serial.println("Buffers de comunicación limpiados. Esperando nuevo comando...");

      while (Serial.available() > 0) {
        Serial.read(); // Lee y descarta cada byte del búfer USB
      }
    }
  }
}

// ==================== MÁQUINA DE ESTADOS DE CARRIL ====================
float procesarEstadoEsperandoComando() {
  // Sistema detenido esperando comando
  return 90.0;
}

float procesarEstadoEvaluandoPosicion() {
  
  float distanciaIzq = leerToF('I');
  float distanciaDer = leerToF('D');
  
  // Determinar qué sensor usar para el control principal según 'sentidoVehiculo'
  char ladoControlEvaluacion = (sentidoVehiculo == DERECHA) ? 'I' : 'D';
  float distanciaControl = (ladoControlEvaluacion == 'I') ? distanciaIzq : distanciaDer;

  Serial.println(" Sin obstáculos detectados, evaluando posición normal");
  
  if (distanciaControl < 0 || distanciaControl > 200) {
    Serial.println("⚠ No se puede leer distancia, manteniendo posición");
    cambiarEstado(ESPERANDO_COMANDO_CARRIL);
    return 90.0;
  }
  
  // =========================================================================
  // Verificar si el robot YA ESTÁ en el carril objetivo
  // dependiendo de si el carril representa la distancia corta o larga
  // según el sentido de giro.
  // =========================================================================
  
  const float MIN_DISTANCIA_CORTA = 0.0;
  const float MAX_DISTANCIA_CORTA = 26.0;
  
  const float MIN_DISTANCIA_LARGA = 65.0;
  const float MAX_DISTANCIA_LARGA = 83.0;

  bool yaEnCarrilObjetivo = false;

  if (carriles.carrilObjetivo == 1) {
    if (sentidoVehiculo == IZQUIERDA) {
      // Pared a la derecha -> Carril 1 es la distancia corta
      if (distanciaControl >= MIN_DISTANCIA_CORTA && distanciaControl <= MAX_DISTANCIA_CORTA) {
          yaEnCarrilObjetivo = true;
      }
    } else if (sentidoVehiculo == DERECHA) {
      // Pared a la izquierda -> Carril 1 es la distancia larga
      if (distanciaControl >= MIN_DISTANCIA_LARGA && distanciaControl <= MAX_DISTANCIA_LARGA) {
          yaEnCarrilObjetivo = true;
      }
    }
  } else if (carriles.carrilObjetivo == 2) {
    if (sentidoVehiculo == IZQUIERDA) {
      // Pared a la derecha -> Carril 2 es la distancia larga
      if (distanciaControl >= MIN_DISTANCIA_LARGA && distanciaControl <= MAX_DISTANCIA_LARGA) {
          yaEnCarrilObjetivo = true;
      }
    } else if (sentidoVehiculo == DERECHA) {
      // Pared a la izquierda -> Carril 2 es la distancia corta
      if (distanciaControl >= MIN_DISTANCIA_CORTA && distanciaControl <= MAX_DISTANCIA_CORTA) {
          yaEnCarrilObjetivo = true;
      }
    }
  }

  // Si ya estamos dentro del rango del carril, saltamos el giro
  if (yaEnCarrilObjetivo && !carriles.esComandoC14 && carriles.esComandoC21 && carriles.esComandoC20) {
    Serial.println("✅ El vehículo ya está en el Carril " + String(carriles.carrilObjetivo) + 
                     " (Sensor " + String(ladoControlEvaluacion) + ": " + String(distanciaControl, 1) + "cm).");
    Serial.println(">> OMITIENDO GIRO: Pasando directo a MANTENIENDO_CARRIL.");
    
    // Actualizar el lado de control para el mantenimiento de pared
    controlLateral.ladoControl = ladoControlEvaluacion;
    
    omitioGiro = true; // Marcar que no hubo giro previo
    cambiarEstado(MANTENIENDO_CARRIL);
    return 90.0;
  }
  // =========================================================================

  // --- SI NO ESTÁ EN EL CARRIL, SE PROCEDE CON EL GIRO NORMAL ---
  float distanciaObjetivo = obtenerDistanciaObjetivo();
  float diferencia = distanciaControl - distanciaObjetivo;
  
  Serial.println(" Carril " + String(carriles.carrilObjetivo) + 
                " | Sensor: " + String(ladoControlEvaluacion) +
                " | Distancia actual: " + String(distanciaControl, 1) + 
                "cm | Objetivo: " + String(distanciaObjetivo, 1) + 
                "cm | Diferencia: " + String(diferencia, 1) + "cm");
  
  // Determinar la dirección del giro basado únicamente en el carril objetivo.
  if (carriles.carrilObjetivo == 1) {
    // Para ir al carril 1, SIEMPRE giramos a la DERECHA.
    carriles.direccionGiro = 1.0; 
  } else { 
    // Para ir al carril 2, SIEMPRE giramos a la IZQUIERDA.
    carriles.direccionGiro = -1.0;
  }

  // Actualizar el lado de control según el carril
  controlLateral.ladoControl = ladoControlEvaluacion;
  
  Serial.println(" Iniciando giro hacia carril " + String(carriles.carrilObjetivo) + 
                " (sensor: " + String(ladoControlEvaluacion) + 
                ", dirección: " + String(carriles.direccionGiro > 0 ? "derecha" : "izquierda") + ")");
                
  cambiarEstado(GIRANDO_HACIA_CARRIL);
  
  return 90.0;
}
// Función auxiliar para verificar si el ángulo está dentro del umbral
bool estaEnRangoAngulo(float anguloActual, float anguloObjetivo, float umbral = 3.0) {
  float diferencia = abs(anguloActual - anguloObjetivo);
  
  // Manejar la transición 0°-360°
  if (diferencia > 180.0) {
    diferencia = 360.0 - diferencia;
  }
  
  return diferencia <= umbral;
}
float procesarEstadoGirandoHaciaCarril() {
  // el cooldown ahora se activa inmediatamente en 'procesarComandoCarril'.
  // Variables estáticas para recordar el estado de la interrupción
  static bool sharpInterrupcionActiva = false;
  static bool lineaInterrupcionActiva = false;
  static unsigned long tiempoInicioInterrupcion = 0;
  static bool pausaPorSharpRealizada = false;
  
  // Variables estáticas para el control de las fases
  static float anguloGiroFijo = 90.0;
  static bool anguloCalculado = false;
  static bool mensajeFase1Mostrado = false;
  static bool mensajeFase2Mostrado = false;
  

  // Resetear el estado cada vez que se entra a este estado de giro
  static unsigned long ultimoTiempoInicioEstado = 0;
  if (carriles.tiempoInicioEstado != ultimoTiempoInicioEstado) {
    sharpInterrupcionActiva = false;
    lineaInterrupcionActiva = false;
    pausaPorSharpRealizada = false;
    anguloCalculado = false; 
    
    // Reseteamos los flags de los mensajes para el nuevo giro
    mensajeFase1Mostrado = false;
    mensajeFase2Mostrado = false;
        enFaseContragiro = false; // Resetear para que el nuevo giro arranque a velocidad normal


    ultimoTiempoInicioEstado = carriles.tiempoInicioEstado;
    Serial.println("🔄 Nuevo giro iniciado - Sistemas de interrupción reseteados.");

    // ── NUEVO: Girar el servo a su posición de giro inicial ANTES de arrancar ──
    // Esto garantiza que C21 (y cualquier otro comando) respete la posición
    // del servo antes de que el loop active avanzarMotor().
    float anguloArranque = 90.0;
    if (carriles.esComandoC21) {
      anguloArranque = (carriles.direccionGiro < 0) ? 180.0 : 0.0;
    } else if (carriles.esComandoC14) {
      anguloArranque = (carriles.direccionGiro < 0) ? 180.0 : 0.0;
    } else {
      // Para los demás comandos, usar el ángulo general según la dirección
      anguloArranque = (carriles.direccionGiro < 0) ? 170.0 : 10.0;
    }
    detenerMotor();
    direccion.write((int)anguloArranque);
    Serial.println("⏳ Pausa de arranque: servo posicionado a " + String((int)anguloArranque) + "° antes de avanzar.");
    delay(300); // Tiempo para que el servo llegue. Ajustable entre 200-400ms.
    avanzarMotor();
    // ──────────────────────────────────────────────────────────────────────────
  }

  unsigned long tiempoEnGiro = millis() - carriles.tiempoInicioEstado;
  unsigned long tiempoGiroActual;
    if (carriles.esComandoC21 && carriles.carrilObjetivo == 1) tiempoGiroActual = 1400;//1600
  else if (carriles.esComandoC21 && carriles.carrilObjetivo == 2) tiempoGiroActual = 1500;//1700;
  
  else if (carriles.esComandoC20 && carriles.carrilObjetivo == 2) tiempoGiroActual = 800;//1800;

  else if (carriles.esComandoC20 && carriles.carrilObjetivo == 1) tiempoGiroActual = 1200;//1800;

  else if (carriles.esComandoC14 && carriles.carrilObjetivo == 1) tiempoGiroActual = 2000;//2000;

  else if (carriles.esComandoC15 && carriles.carrilObjetivo == 1) tiempoGiroActual = 800;//1900;

  else if (carriles.esComandoC15 && carriles.carrilObjetivo == 2) tiempoGiroActual = 1200;//1900;

  //C33 (Rojo, Adelante Izquierda y Verde, Atrás Izquierda)
  //Primer giro
  else if (carriles.esComandoC33 && carriles.carrilObjetivo == 1) tiempoGiroActual = 1100;//1550;
  // retorno
  else if (carriles.esComandoC33 && carriles.carrilObjetivo == 2) tiempoGiroActual = 1500;//2200;
  //C26 (Verde, Adelante Derecha y Rojo, Atrás Derecha)
  // Primer giro verde izquierda
  else if (carriles.esComandoC26 && carriles.carrilObjetivo == 2) tiempoGiroActual = 1100;//1800;
  // retorno rojo izquierda
  else if (carriles.esComandoC26 && carriles.carrilObjetivo == 1) tiempoGiroActual = 1500;//1800;
  //C27 (Rojo, Adelante Derecha y Verde, Atrás Derecha)
  else if (carriles.esComandoC27 && carriles.carrilObjetivo == 1) tiempoGiroActual = 1400;//1600;
  else if (carriles.esComandoC27 && carriles.carrilObjetivo == 2) tiempoGiroActual = 800;//1800;
  //C32 (Verde, Adelante Izquierda y Rojo, Atrás Izquierda
  else if (carriles.esComandoC32 && carriles.carrilObjetivo == 1) tiempoGiroActual = 1500;//1600;

  else if (carriles.esComandoC32 && carriles.carrilObjetivo == 2) tiempoGiroActual = 1300;//1800;

  else if (carriles.esComandoC08 && carriles.carrilObjetivo == 1) tiempoGiroActual = 1500;//2000;
  
  else if (carriles.esComandoC36 && carriles.carrilObjetivo == 1) tiempoGiroActual = 1500;//2000;
  
  else if (carriles.carrilObjetivo == 1)  {
    tiempoGiroActual = carriles.tiempoGiroCarril1;
    Serial.println(" TIEMPO ARBITRARIO CARRIL 1");

    }

  else if (carriles.carrilObjetivo == 2){ 
   tiempoGiroActual = carriles.tiempoGiroCarril2;
    Serial.println(" TIEMPO ARBITRARIO CARRIL 2");

    }
  else{ 
    tiempoGiroActual = carriles.tiempoGiro;
    Serial.println(" TIEMPO ARBITRARIO CARRIL GIRO");
}
  // LÓGICA DE INTERRUPCIÓN 
  if (!sharpInterrupcionActiva && !lineaInterrupcionActiva) {
    float distanciaFrontalGiro = leerToF('F');

    float distancia_interrupcion_frontal = 38.0; // Valor por defecto para todos los comandos
    
    if (carriles.esComandoC26 && carriles.carrilObjetivo == 1) {
      Serial.println(" cambiado por 30cm");
      distancia_interrupcion_frontal = 30.0;
    }
    if (distanciaFrontalGiro <= distancia_interrupcion_frontal && distanciaFrontalGiro > 0) {
      Serial.println(" INTERRUPCIÓN POR TOF FRONTAL! (" + String(distanciaFrontalGiro, 1) + "cm). Saltando a la fase de corrección AHORA.");
      sharpInterrupcionActiva = true; 
      tiempoInicioInterrupcion = millis();
    }
    else {
      //miestras esta retornando al angulo objtivo no me detecte colores por un tiempo especifico
        if (millis() - tiempoUltimaDeteccion > tiempoEsperaDeteccion) {
            bool lineaDetectada = false;
            if (sentidoVehiculo == IZQUIERDA) {
                if (confirmarColor(HUE_AZUL_MIN, HUE_AZUL_MAX, SATURACION_AZUL_MIN, VALOR_AZUL_MIN, VALOR_AZUL_MAX, CONFIRMAR_AZUL_TOLERANCIA, CONFIRMAR_AZUL_DELAY)) {
                    lineaDetectada = true;
                    Serial.println(" INTERRUPCIÓN POR LÍNEA AZUL! Saltando a la fase de corrección AHORA.");
                }
            }
            else if (sentidoVehiculo == DERECHA) {
                if (confirmarColor(HUE_NARANJA_MIN, HUE_NARANJA_MAX, SATURACION_NARANJA_MIN, VALOR_NARANJA_MIN, VALOR_NARANJA_MAX, CONFIRMAR_NARANJA_TOLERANCIA, CONFIRMAR_NARANJA_DELAY)) {
                    lineaDetectada = true;
                    Serial.println(" INTERRUPCIÓN POR LÍNEA NARANJA! Saltando a la fase de corrección AHORA.");
                }
            }
            if (lineaDetectada) {
                lineaInterrupcionActiva = true;
                tiempoInicioInterrupcion = millis();
            }
        }
      }
  }

  // ==================== ====================
  // FASE DE CORRECCIÓN Y ENDEREZADO (Lógica Unificada)
  if (tiempoEnGiro >= tiempoGiroActual || sharpInterrupcionActiva || lineaInterrupcionActiva) { 
    // ── SEGURO: Si la desviación respecto al objetivo es pequeña, no hace falta contragiro ──
    if (!primerGiroRealizado) {
        anguloObjetivo = 0.0;
    } else {
        calcularAnguloObjetivoMantener();
    }

    const float UMBRAL_CONTRAGIRO = 8.0; // Si está a menos de 12° del objetivo, va directo
    if (estaEnRangoAngulo(anguloZ, anguloObjetivo, UMBRAL_CONTRAGIRO)) {
        Serial.println("✅ Desviación pequeña, sin contragiro. Directo a MANTENIENDO_CARRIL.");
        controlLateral.ladoControl = obtenerLadoControlPorCarril();
        cambiarEstado(MANTENIENDO_CARRIL);
        return 90.0;
    }
    // ─────────────────────────────────────────────────────────────────────────────────────

   // ── VERIFICACIÓN SHARP DENTRO DE LA FASE DE CORRECCIÓN ───────────────
    static unsigned long ultimoRetrocesoSharpCorreccion = 0;
    const unsigned long COOLDOWN_SHARP_CORRECCION = 400; // ms de pausa entre retrocesos

    float distSharpCorreccion = 999;
    if (carriles.carrilObjetivo == 1) {
      distSharpCorreccion = leerSensorSharp(SHARP_DIAGONAL_DER_PIN);
    } else {
      distSharpCorreccion = leerSensorSharp(SHARP_DIAGONAL_IZQ_PIN);
    }

    float distanciaLimite = 14.0; // Valor por defecto
    if (carriles.esComandoC20) {
      distanciaLimite = 14.0;
    } else if (carriles.esComandoC21) {
      distanciaLimite = 14.0;
    } else if (carriles.esComandoC14) {
      distanciaLimite = 14.0;
    }

    if (distSharpCorreccion <= distanciaLimite && distSharpCorreccion > 0 &&
        millis() - ultimoRetrocesoSharpCorreccion > COOLDOWN_SHARP_CORRECCION) {

      Serial.println("⚠️ SHARP en CORRECCIÓN: " + String(distSharpCorreccion, 1) + "cm. Retrocediendo...");

      detenerMotor();
      direccion.write(90);
      delay(200);

      retrocederMotor();
      unsigned long t0 = millis();
      unsigned long duracion = (carriles.esComandoC21 || carriles.esComandoC14) ? 800 : 800;
      while (millis() - t0 < duracion) {
        actualizarGiro();
        delay(10);
      }
      detenerMotor();
      delay(100);

      if (carriles.direccionGiro < 0) {
        direccion.write(180);
      } else {
        direccion.write(0);
      }
      delay(300);

      avanzarMotor();
      ultimoRetrocesoSharpCorreccion = millis(); // marca el tiempo del último retroceso
      Serial.println("▶️ SHARP CORRECCIÓN: Reanudando enderezado.");
    }
    // ─────────────────────────────────────────────────────────────────────
   // Manejo de la interrupción por ToF Frontal → contragiro directo sin detener
    if (sharpInterrupcionActiva && !pausaPorSharpRealizada) {
      Serial.println("↩️ TOF FRONTAL: Iniciando contragiro directo...");

      // Detener el motor, girar el servo y esperar a que llegue antes de avanzar
      detenerMotor();

      if (carriles.carrilObjetivo == 1) {
        direccion.write(180); // Giro inicial fue derecha, contragiro es izquierda
      } else {
        direccion.write(0);   // Giro inicial fue izquierda, contragiro es derecha
      }

      delay(300); // Pausa para que el servo alcance su posición antes de avanzar

      avanzarMotor(); // Reanudar avance ya con el servo en posición

      pausaPorSharpRealizada = true;
      tiempoInicioInterrupcion = millis();
      Serial.println("▶️ Contragiro activo. FASE A controlará por ángulo.");
    }

    // 1. Calcular el ángulo objetivo final
    // Protección: durante los primeros 400ms tras la interrupción forzar el contragiro
    // para evitar que un ángulo casual mande a MANTENIENDO antes de cruzar.
    if (sharpInterrupcionActiva && (millis() - tiempoInicioInterrupcion < 400)) {
      return (carriles.carrilObjetivo == 1) ? 180.0 : 0.0;
    }

    if (!primerGiroRealizado) {
        anguloObjetivo = 0.0;
        if (!mensajeFase2Mostrado) {
            Serial.println(">>> PRIMER GIRO: Ángulo de enderezado forzado a 0.0°");
        }
    } else {
        calcularAnguloObjetivoMantener();
    }

    // 2. Verificar si ya hemos llegado al ángulo objetivo
    if (estaEnRangoAngulo(anguloZ, anguloObjetivo, 8.0)) {
      Serial.println(" Ángulo corregido. Pasando a mantener carril.");
      enFaseContragiro = false;
      controlLateral.ladoControl = obtenerLadoControlPorCarril();
      cambiarEstado(MANTENIENDO_CARRIL);
      return 90.0;
      // ── NUEVO: Detectar si se sobrepasó el ángulo objetivo ──────────────
      // En el contragiro: carril 1 gira a izquierda (anguloZ sube), carril 2 gira a derecha (anguloZ baja)
      float errorContragiro = calcularDiferenciaAngular(anguloZ, anguloObjetivo);
      bool sobrepasado = false;
      if (carriles.carrilObjetivo == 1 && errorContragiro < -5.0) {
          sobrepasado = true; // Iba subiendo y ya pasó por arriba del objetivo
      } else if (carriles.carrilObjetivo == 2 && errorContragiro > 5.0) {
          sobrepasado = true; // Iba bajando y ya pasó por debajo del objetivo
      }

      if (sobrepasado) {
          Serial.println("⚠️ Contragiro sobrepasado. Forzando MANTENIENDO_CARRIL.");
          cambiarEstado(MANTENIENDO_CARRIL);
          return 90.0;
      }
    } else {
        if (!mensajeFase2Mostrado) {
            Serial.println(" Fase 2: Ejecutando contra-giro hasta enderezar.");
            mensajeFase2Mostrado = true;
        }
        enFaseContragiro = true; // Activar velocidad lenta en el loop
        if (carriles.carrilObjetivo == 1) {
            return 180.0;
        } else {
            return 0.0;
        }
    }
  }
  // ===================== ======================

  // FASE B: GIRO INICIAL 
  else {
    if (!anguloCalculado) {
      if (!mensajeFase1Mostrado) {
        Serial.println("🔄 Fase 1: Ejecutando giro inicial por tiempo (cálculo único).");
        mensajeFase1Mostrado = true;
      }
    
      float servoAngleTemporal = 90.0;
 
      if (carriles.esComandoC15) {
        if (carriles.carrilObjetivo == 1) {
          // Para el primer tramo del C15 (hacia carril 1), el giro es a 40 grados.
          servoAngleTemporal = 30.0;//50
          Serial.println("   -> Comando C15 (Fase 1/2): Ángulo de giro FIJO a 40°.");
        } else { // carriles.carrilObjetivo == 2
          // Para el segundo tramo (hacia carril 2), el giro es a 140 grados.
          servoAngleTemporal = 120.0;//160
          Serial.println("   -> Comando C15 (Fase 2/2): Ángulo de giro FIJO a 140°.");
        }
      } else if (carriles.esComandoC20) { 
        if (carriles.carrilObjetivo == 2) {
          // Para el primer tramo del C20 (hacia carril 2, izq.), el giro es a 140 grados.
          servoAngleTemporal = 140.0;//140
          Serial.println("   -> Comando C20 (Fase 1/2): Ángulo de giro FIJO a 140°.");
        } else { // carriles.carrilObjetivo == 1
          // Para el segundo tramo (hacia carril 1, der.), el giro es a 40 grados.
          servoAngleTemporal = 0.0;//40
          Serial.println("   -> Comando C20 (Fase 2/2): Ángulo de giro FIJO a 40°.");
        }
      }   else if (carriles.esComandoC26) {
        if (carriles.carrilObjetivo == 2) {
          // Para el primer tramo del C26 (hacia carril 2, izq.), el giro es a 140 grados.
          servoAngleTemporal = 140.0;
          Serial.println("   -> Comando C26 (Fase 1/2): Ángulo de giro FIJO a 140°.");
        } else { // carriles.carrilObjetivo == 1
          // Para el segundo tramo (hacia carril 1, der.), el giro es a 20 grados.
          servoAngleTemporal = 0.0;
          Serial.println("   -> Comando C26 (Fase 2/2): Ángulo de giro FIJO a 0°.");
         }
       } else if (carriles.esComandoC33) {
        if (carriles.carrilObjetivo == 1) {
          // Para el primer tramo del C33 (hacia carril 1, dere.), el giro es a 40 grados.
          servoAngleTemporal = 30.0;
          Serial.println("   -> C33 Comando (Phase 1/2): Ángulo de giro FIJO a 30°");
        } else { // carriles.carrilObjetivo == 2
          //Para el primer tramo del C33 (hacia carril 2, izq.), el giro es a 160 grados.
          servoAngleTemporal = 180.0;
          Serial.println("   -> C33 Command (Phase 2/2): Ángulo de giro FIJO a 180°.");
          }
        }
       else if (carriles.esComandoC21) {
        Serial.println("   -> Comando C21: Aplicando ángulo de giro reducido.");
        if (carriles.direccionGiro < 0) { // Giro a la IZQUIERDA
          servoAngleTemporal = 180.0; // Ángulo solicitado para la izquierda
          Serial.println("       Giro a la IZQUIERDA a 180°.");
        } else { // Giro a la DERECHA
          servoAngleTemporal = 0.0; // Ángulo solicitado para la derecha
          Serial.println("       Giro a la DERECHA a 0°.");
        }
      }  else if (carriles.esComandoC14) {
        Serial.println("   -> Comando C14: Aplicando ángulo de giro reducido.");
        if (carriles.direccionGiro < 0) { // Giro a la IZQUIERDA
          servoAngleTemporal = 170.0; // Ángulo solicitado para la izquierda
          Serial.println("       Giro a la IZQUIERDA a 170°.");
        } else { // Giro a la DERECHA
          servoAngleTemporal = 0.0; // Ángulo solicitado para la derecha
          Serial.println("       Giro a la DERECHA a °0.");
        }
      } else if (carriles.esComandoC27) {
        if (carriles.carrilObjetivo == 1) {
          // Para el primer tramo del C27 (hacia carril 1, dere.), el giro es a 20 grados.
          servoAngleTemporal = 0.0;
          Serial.println("   -> Comando C27 (Fase 1/2): Ángulo de giro FIJO a 0°.");
        } else { // carriles.carrilObjetivo == 2
          // Para el segundo tramo (hacia carril 2, der.), el giro es a 160 grados.
          servoAngleTemporal = 160.0;
          Serial.println("   -> Comando C27 (Fase 2/2): Ángulo de giro FIJO a 160°.");
        } 
      } else if (carriles.esComandoC32) {
        if (carriles.carrilObjetivo == 2) {
          // Para el primer tramo del C32 (hacia carril 2, izq.), el giro es a 160 grados.
          servoAngleTemporal = 170.0;
          Serial.println("   -> Comando C32 (Fase 1/2): Ángulo de giro FIJO a 170°.");
        } else { // carriles.carrilObjetivo == 1
          // Para el segundo tramo (hacia carril 1, der.), el giro es a 20 grados.
          servoAngleTemporal = 0.0;
          Serial.println("   -> Comando C32 (Fase 2/2): Ángulo de giro FIJO a 0°.");
         }
       }
       else if (carriles.esComandoC02) {
        if (carriles.carrilObjetivo == 1) {
          // rojo derecha
          servoAngleTemporal = 0.0;
          Serial.println("   -> C02 Comando : Ángulo de giro FIJO a 0°");
          }
        }
        else if (carriles.esComandoC08 ||carriles.esComandoC36 ) {
        if (carriles.carrilObjetivo == 1) {
          // rojo izquierda
          servoAngleTemporal = 20.0;
          Serial.println("   -> C08 Comando : Ángulo de giro FIJO a 20°");
          } 
        }
        else if (carriles.esComandoC01) {
        if (carriles.carrilObjetivo == 2) {
          // rojo izquierda
          servoAngleTemporal = 170.0;
          Serial.println("   -> C01 Comando : Ángulo de giro FIJO a 170°");
          } 
        }else if (carriles.esComandoC07) {
        if (carriles.carrilObjetivo == 2) {
          // rojo izquierda
          servoAngleTemporal = 170.0;
          Serial.println("   -> C07 Comando : Ángulo de giro FIJO a 170°");
          } 
        }
      else { // Lógica original para todos los demás comandos
          bool calcularAnguloVariable = (carriles.carrilObjetivo == 1 && sentidoVehiculo == DERECHA) ||
                                        (carriles.carrilObjetivo == 2 && sentidoVehiculo == IZQUIERDA); 
          
          if (calcularAnguloVariable) {
              Serial.println("--- [Ángulo Variable Activo] ---");
              float distanciaLateral = -1.0; 
              if (carriles.carrilObjetivo == 1) {
                  distanciaLateral = leerToF('I');
                  Serial.print("Carril Objetivo 1: Leyendo ToF Izquierdo -> Distancia: ");
                  Serial.println(distanciaLateral);
              } else {
                  distanciaLateral = leerToF('D'); 
                  Serial.print("Carril Objetivo 2: Leyendo ToF Derecho -> Distancia: ");
                  Serial.println(distanciaLateral);
              }
              
              if (distanciaLateral > 0 && distanciaLateral < 100) {
                  float distanciaRestringida = constrain(distanciaLateral, 32.0, 50.0);
                  float ajuste = map(distanciaRestringida, 32.0, 50.0, 0.0, 20.0); 
                  
                  Serial.print("Distancia acotada (32-50): ");
                  Serial.print(distanciaRestringida);
                  Serial.print(" | Ajuste calculado por map: ");
                  Serial.println(ajuste);

                  if (carriles.direccionGiro < 0) { 
                      servoAngleTemporal = 170.0 - ajuste; 
                      Serial.print("Giro Izquierda. Servo Temporal (170 - ajuste): ");
                      Serial.println(servoAngleTemporal);
                  } else { 
                      servoAngleTemporal = 10.0 + ajuste; 
                      Serial.print("Giro Derecha. Servo Temporal (10 + ajuste): ");
                      Serial.println(servoAngleTemporal);
                  }
              } else {
                  Serial.print("Distancia ToF fuera de rango (0-100). Valor obtenido: ");
                  Serial.println(distanciaLateral);
                  
                  if (carriles.direccionGiro < 0) {
                      servoAngleTemporal = 170.0;
                      Serial.println("Aplicando giro fijo Izquierda: 170.0");
                  } else {
                      servoAngleTemporal = 10.0;
                      Serial.println("Aplicando giro fijo Derecha: 10.0");
                  }
              }
          } else {
              Serial.println("--- [Giro Fijo Activo] (No cumple condiciones de carril/sentido) ---");
              if (carriles.direccionGiro < 0) {
                  servoAngleTemporal = 170.0;
                  Serial.println("Giro Fijo Izquierda: 170.0");
              } else {
                  servoAngleTemporal = 10.0;
                  Serial.println("Giro Fijo Derecha: 10.0");
              }
          }
      }

      anguloGiroFijo = constrain(servoAngleTemporal, 0, 180);
      anguloCalculado = true;
      
      Serial.print(">>> ANGULO FINAL ENVIADO AL SERVO: ");
      Serial.println(anguloGiroFijo);
      Serial.println("----------------------------------------");

      // ── NUEVO: Girar el servo ANTES de arrancar el motor ──────────────
      // Se escribe el ángulo aquí mismo y se espera a que el servo llegue
      // a su posición antes de que el loop principal active avanzarMotor().
      direccion.write((int)anguloGiroFijo);
      delay(400); // 300ms le da tiempo al servo de posicionarse. Puedes ajustar entre 200-500ms.
      // ──────────────────────────────────────────────────────────────────
    }
    
   // ── CONTROL DE DESVIACIÓN MÁXIMA DE 45° ─────────────────────────────
    // Calcular cuánto nos hemos desviado desde que inició el giro
    float desviacionActual = 0.0;
    if (carriles.carrilObjetivo == 1) {
      // Giro a la derecha: el ángulo Z baja (se hace negativo o sube hacia 360)
      desviacionActual = calcularDiferenciaAngular(anguloZ, anguloObjetivoGlobal);
      desviacionActual = abs(desviacionActual);
    } else {
      // Giro a la izquierda: el ángulo Z sube
      desviacionActual = calcularDiferenciaAngular(anguloZ, anguloObjetivoGlobal);
      desviacionActual = abs(desviacionActual);
    }
    float MAX_DESVIACION_GIRO = 35.0;
     if (carriles.esComandoC20|| carriles.esComandoC15 ) { 
      MAX_DESVIACION_GIRO = 15.0;
     }else if(carriles.esComandoC26 && carriles.carrilObjetivo == 1 || carriles.esComandoC32 && carriles.carrilObjetivo == 1){
      MAX_DESVIACION_GIRO = 45.0;
     }else if(carriles.esComandoC26 && carriles.carrilObjetivo == 2){
      MAX_DESVIACION_GIRO = 21.0;
     }else if(carriles.esComandoC27 && carriles.carrilObjetivo == 2){
      MAX_DESVIACION_GIRO = 20.0;
     }else if(carriles.esComandoC14 && carriles.carrilObjetivo == 1){
      MAX_DESVIACION_GIRO = 70.0;
     }
    unsigned long ahoraA = millis();
    if (desviacionActual >= MAX_DESVIACION_GIRO) {
       if (ahoraA - ultimaImpresion_maxAngulo >= INTERVALO_maxAngulo) {
          ultimaImpresion_maxAngulo = ahoraA;  // Actualiza el tiempo
          Serial.println("*");
          Serial.print("regulacion de grados: ");
          Serial.print(MAX_DESVIACION_GIRO);
          Serial.println(" grados************");
        }
      // Alcanzó el máximo permitido: mantener ruedas centradas para
      // no desviarse más, esperar a que el tiempo termine y empiece el contragiro
      return 90.0;
    }
    // ────────────────────────────────────────────────────────────────────

    return anguloGiroFijo;
  }
}

float procesarEstadoEnderezandoCarril() {

  
  if (abs(anguloZ) <= carriles.toleranciaAngulo) {
    Serial.println("📐 Vehículo enderezado, iniciando mantenimiento de carril");
    cambiarEstado(MANTENIENDO_CARRIL);
    return 90.0;
  }
  
  // Control proporcional para enderezar
  float correccionAngulo = -anguloZ * 2.0;  // Ganancia proporcional
  correccionAngulo = constrain(correccionAngulo, -40, 50);
  
  return constrain(90.0 + correccionAngulo, 0, 180);
}
float obtenerDistanciaPorSentido(char lado) {
  float lectura;
  if (lado == 'I') {
    lectura = leerToF('I');
    return controlLateral.filtroIzquierda.filtrar(lectura);
  } else {
    lectura = leerToF('D');
    return controlLateral.filtroDerecha.filtrar(lectura);
  }
}
float procesarMantenimientoPared() {
      enFaseContragiro = false; // Resetear para que al entrar en manteniendo vaya a velicidad normal

  // ── 1. VERIFICACIÓN FRONTAL ────────────────────────────────────────────────
  float distanciaFrontal = leerToF('F');
  if (distanciaFrontal > 0 && distanciaFrontal < 15.0) {
    Serial.println("!!! OBSTÁCULO FRONTAL (" + String(distanciaFrontal, 1) + "cm) !!!");
    detenerMotor();
    direccion.write(SERVO_CENTER);
    delay(100);
    
    // Retroceder 
    Serial.println("⏪ Retrocediendo por obstáculo frontal...");
    retrocederMotor();
    unsigned long t0 = millis();
    while (millis() - t0 < 900) { actualizarGiro(); delay(10); }
    detenerMotor(); delay(100);

    // Evaluar distancia lateral post-retroceso
    // Carril 1 → sensor DERECHO | Carril 2 → sensor IZQUIERDO
    {
      const float UMBRAL_LEJOS_PARED = 1.0; // cm extra sobre el objetivo para considerar "lejos"
      float distLateral = 999.0;
      String ladoStr = "";
      if (carriles.carrilObjetivo == 1) {
        distLateral = leerToF('D');
        ladoStr = "DER";
      } else {
        distLateral = leerToF('I');
        ladoStr = "IZQ";
      }
      float distanciaObjetivoCarril = obtenerDistanciaObjetivo();

      Serial.print("📏 Post-retroceso | Sensor ");
      Serial.print(ladoStr);
      Serial.print(": ");
      Serial.print(distLateral, 1);
      Serial.print("cm | Objetivo: ");
      Serial.print(distanciaObjetivoCarril, 1);
      Serial.println("cm");

      bool estaLejos = (distLateral > (distanciaObjetivoCarril + UMBRAL_LEJOS_PARED)) ||
                       (distLateral <= 0 || distLateral > 150);

      if (estaLejos) {
        Serial.println("🔄 Está LEJOS de la pared. Iniciando giro evasivo hacia el carril...");
        cambiarEstado(GIRANDO_HACIA_CARRIL);
      } else {
        Serial.println("✅ Está CERCA de la pared. Solo retroceso fue suficiente. Volviendo a MANTENIENDO_CARRIL.");
        avanzarMotor();
        cambiarEstado(MANTENIENDO_CARRIL);
      }
    }
    return -1.0;
  }

  // ── 2. EMERGENCIA SHARP ────────────────────────────────────────────────────
  if (carriles.carrilObjetivo == 1) {
    float d = leerSensorSharp(SHARP_DIAGONAL_DER_PIN);
    if (d > 0 && d < DISTANCIA_EMERGENCIA_SHARP_PARED) {
      detenerMotor();
      direccion.write(SERVO_RIGHT); 
      delay(100);
      retrocederMotor();
      unsigned long t0 = millis();
      while (millis() - t0 < TIEMPO_RETROCESO_SHARP_PARED) { 
        actualizarGiro(); 
        delay(10);
       }
      detenerMotor(); 
      direccion.write(SERVO_CENTER); 
      avanzarMotor();
      return ANGULO_CORRECCION_SHARP_IZQ;
    }
  } else {
    float d = leerSensorSharp(SHARP_DIAGONAL_IZQ_PIN);
    if (d > 0 && d < DISTANCIA_EMERGENCIA_SHARP_PARED) {
      detenerMotor(); direccion.write(SERVO_LEFT); delay(100);
      retrocederMotor();
      unsigned long t0 = millis();
      while (millis() - t0 < TIEMPO_RETROCESO_SHARP_PARED) { actualizarGiro(); delay(10); }
      detenerMotor(); direccion.write(SERVO_CENTER); avanzarMotor();
      return ANGULO_CORRECCION_SHARP_DER;
    }
  }

  // ── 3. LECTURA SENSOR LATERAL ──────────────────────────────────────────────
  // Carril 1 → sensor DERECHO | Carril 2 → sensor IZQUIERDO
  char ladoControl = obtenerLadoControlPorCarril(); // 'D' o 'I'
  float distanciaControl = obtenerDistanciaPorSentido(ladoControl);
  if (distanciaControl <= 0 || distanciaControl > 150) return 90.0;

  // ── 4. ÁNGULO OBJETIVO ────────────────────────────────────────────────────
  if (!primerGiroRealizado) {
    anguloObjetivo = 0.0;
  } else {
    calcularAnguloObjetivoMantener();
  }
  controlLateral.anguloObjetivo = anguloObjetivo;

  // Error de ángulo normalizado [-180, 180]
  // positivo = Yaw < objetivo → robot apunta menos de lo que debería
  // negativo = Yaw > objetivo → robot apunta más de lo que debería
  float errorAngulo = anguloObjetivo - anguloZ;
  if (errorAngulo >  180.0) errorAngulo -= 360.0;
  if (errorAngulo < -180.0) errorAngulo += 360.0;

  // ── 5. ERROR DE DISTANCIA (PID) ────────────────────────────────────────────
  float distanciaObjetivo = obtenerDistanciaObjetivo();
  // positivo = demasiado lejos de la pared, negativo = demasiado cerca
  float errorDistancia = distanciaControl - distanciaObjetivo;

  controlLateral.integralDistancia += errorDistancia;
  controlLateral.integralDistancia = constrain(controlLateral.integralDistancia,
                                               -controlLateral.integralMaxDistancia,
                                               controlLateral.integralMaxDistancia);
  float derivadaDistancia = errorDistancia - controlLateral.errorDistanciaAnterior;
  controlLateral.errorDistanciaAnterior = errorDistancia;

  float correccionDistancia = (controlLateral.kpDistancia * errorDistancia)
                            + (controlLateral.kiDistancia * controlLateral.integralDistancia)
                            + (controlLateral.kdDistancia * derivadaDistancia);

  // ── 6. FUSIÓN Y SIGNO ─────────────────────────────────────────────────────
  //
  // CONVENCIÓN SERVO: servo > 90 → gira IZQUIERDA | servo < 90 → gira DERECHA
  //
  // CARRIL 1 (sensor DERECHO, pared a la derecha):
  //   errorAngulo > 0 → Yaw < obj → apunta muy a la derecha → corregir IZQUIERDA → servo+ ✓ directo
  //   errorAngulo < 0 → Yaw > obj → apunta muy a la izquierda → corregir DERECHA → servo- ✓ directo
  //   errorDistancia > 0 → muy lejos de pared derecha → acercarse → girar DERECHA → servo- → invertir
  //   errorDistancia < 0 → muy cerca de pared derecha → alejarse → girar IZQUIERDA → servo+ → invertir
  //
  // CARRIL 2 (sensor IZQUIERDO, pared a la izquierda):
  //   errorAngulo > 0 → mismo razonamiento → directo
  //   errorAngulo < 0 → mismo razonamiento → directo  
  //   errorDistancia > 0 → muy lejos de pared izquierda → acercarse → girar IZQUIERDA → servo+ → directo
  //   errorDistancia < 0 → muy cerca de pared izquierda → alejarse → girar DERECHA → servo- → directo
  //
  // Resumen: corrección de ángulo siempre DIRECTA.
  //          corrección de distancia: INVERTIDA para carril 1, DIRECTA para carril 2.

  const float KP_ANGULO = 2.5;
  const float UMBRAL_ANGULO_DOMINANTE = 15.0; // ° — por encima de esto el ángulo domina

  float pesoAngulo    = constrain(abs(errorAngulo) / UMBRAL_ANGULO_DOMINANTE, 0.0, 1.0);
  float pesoDistancia = 1.0 - pesoAngulo;

  float corrAngulo = KP_ANGULO * errorAngulo; // siempre directo

  float corrDistancia = correccionDistancia;
  if (ladoControl == 'D') {
    corrDistancia = -corrDistancia; // invertir para carril 1
  }
  // carril 2 (ladoControl == 'I'): directo

  float correccionTotal = (pesoAngulo * corrAngulo) + (pesoDistancia * corrDistancia);

  // Factores de asimetría mecánica
  if (correccionTotal > 0) correccionTotal *= controlLateral.factorGiroIzquierda;
  else                     correccionTotal *= controlLateral.factorGiroDerecha;

  correccionTotal = constrain(correccionTotal,
                              -controlLateral.correccionMaxima,
                              controlLateral.correccionMaxima);

  float valorServo = constrain(90.0 + correccionTotal, 0.0, 180.0);

  // ── 7. DEBUG ──────────────────────────────────────────────────────────────
  static unsigned long ultimoPrint = 0;
  if (millis() - ultimoPrint > 300) {
    Serial.print(F("ToF(")); Serial.print(ladoControl);
    Serial.print(F("):")); Serial.print(distanciaControl, 1);
    Serial.print(F(" ErrD:")); Serial.print(errorDistancia, 1);
    Serial.print(F(" ErrA:")); Serial.print(errorAngulo, 1);
    Serial.print(F(" wA:")); Serial.print(pesoAngulo, 2);
    Serial.print(F(" Srv:")); Serial.println(valorServo, 0);
    ultimoPrint = millis();
  }

  // ── 8. TRANSICIONES AUTOMÁTICAS DE COMANDO ───────────────────────────────
  if (carriles.esComandoC21 && carriles.carrilObjetivo == 1) {
    // Calcular cuánto tiempo llevamos en MANTENIENDO_CARRIL
    unsigned long tiempoEnManteniendo = millis() - carriles.tiempoInicioEstado;

    if (tiempoEnManteniendo >= TIEMPO_AVANCE_MANTENIENDO_C21) {
        // Ya avanzó suficiente, ahora sí proceder al cambio de carril
        Serial.println("⏱️ C21: Tiempo en MANTENIENDO_CARRIL cumplido (" + 
                         String(tiempoEnManteniendo) + "ms). Iniciando cambio a carril 2.");
        carriles.carrilObjetivo = 2;
        controlLateral.ladoControl = 'I';
        cambiarEstado(EVALUANDO_POSICION);
        return -1;
    } else {
        // Aún no ha pasado suficiente tiempo, seguir manteniendo
        Serial.print("⏳ C21: Avanzando en carril 1 antes del cambio... ");
        Serial.print(tiempoEnManteniendo);
        Serial.print("/");
        Serial.println(TIEMPO_AVANCE_MANTENIENDO_C21);
        // No retornar -1: dejar que el PID de pared siga controlando el servo
    }
}
  if (carriles.esComandoC15 && carriles.carrilObjetivo == 1) {
     // Calcular cuánto tiempo llevamos en MANTENIENDO_CARRIL
    unsigned long tiempoEnManteniendo = millis() - carriles.tiempoInicioEstado;

    if (tiempoEnManteniendo >= TIEMPO_AVANCE_MANTENIENDO_C15) {
        // Ya avanzó suficiente, ahora sí proceder al cambio de carril
        Serial.println("⏱️ C15: Tiempo en MANTENIENDO_CARRIL cumplido (" + 
                         String(tiempoEnManteniendo) + "ms). Iniciando cambio a carril 2.");
        carriles.carrilObjetivo = 2; controlLateral.ladoControl = 'I';
        cambiarEstado(EVALUANDO_POSICION); 
        return -1;
    } else {
        // Aún no ha pasado suficiente tiempo, seguir manteniendo
        Serial.print("⏳ C21: Avanzando en carril 1 antes del cambio... ");
        Serial.print(tiempoEnManteniendo);
        Serial.print("/");
        Serial.println(TIEMPO_AVANCE_MANTENIENDO_C15);
        // No retornar -1: dejar que el PID de pared siga controlando el servo
    }

  }
  if (carriles.esComandoC20 && carriles.carrilObjetivo == 2) {
    unsigned long tiempoEnManteniendo = millis() - carriles.tiempoInicioEstado;
    unsigned long tiempoEsperaC20 = TIEMPO_AVANCE_MANTENIENDO_C20 + (omitioGiro ? 1500UL : 0UL);

    if (tiempoEnManteniendo >= tiempoEsperaC20) {
        // Ya avanzó suficiente, ahora sí proceder al cambio de carril
        Serial.println("⏱️ C20: Tiempo en MANTENIENDO_CARRIL cumplido (" + 
                         String(tiempoEnManteniendo) + "ms). Iniciando cambio a carril 1.");
        carriles.carrilObjetivo = 1; controlLateral.ladoControl = 'D';
        carriles.distanciaCarril1 = 22.0;
        cambiarEstado(EVALUANDO_POSICION); 
        return -1;
    } else {
        // Aún no ha pasado suficiente tiempo, seguir manteniendo
        Serial.print("⏳ C20: Avanzando en carril 2 antes del cambio... ");
        Serial.print(tiempoEnManteniendo);
        Serial.print("/");
        Serial.println(tiempoEsperaC20);        // No retornar -1: dejar que el PID de pared siga controlando el servo
    }
  }
  if (carriles.esComandoC26 && carriles.carrilObjetivo == 2) {
    // Calcular cuánto tiempo llevamos en MANTENIENDO_CARRIL
    unsigned long tiempoEnManteniendo = millis() - carriles.tiempoInicioEstado;

    if (tiempoEnManteniendo >= TIEMPO_AVANCE_MANTENIENDO_C26) {
        // Ya avanzó suficiente, ahora sí proceder al cambio de carril
        Serial.println("⏱️ C25: Tiempo en MANTENIENDO_CARRIL cumplido (" + 
                         String(tiempoEnManteniendo) + "ms). Iniciando cambio a carril 1.");
        carriles.carrilObjetivo = 1; 
        controlLateral.ladoControl = 'D';
        carriles.distanciaCarril1 = 22.0;
        cambiarEstado(EVALUANDO_POSICION); 
        return -1;
    } else {
        // Aún no ha pasado suficiente tiempo, seguir manteniendo
        Serial.print("⏳ C26: Avanzando en carril 2 antes del cambio... ");
        Serial.print(tiempoEnManteniendo);
        Serial.print("/");
        Serial.println(TIEMPO_AVANCE_MANTENIENDO_C26);
        // No retornar -1: dejar que el PID de pared siga controlando el servo
    }
  }
  if (carriles.esComandoC32 && carriles.carrilObjetivo == 2) {
    // Calcular cuánto tiempo llevamos en MANTENIENDO_CARRIL
    unsigned long tiempoEnManteniendo = millis() - carriles.tiempoInicioEstado;

    if (tiempoEnManteniendo >= TIEMPO_AVANCE_MANTENIENDO_C32) {
        // Ya avanzó suficiente, ahora sí proceder al cambio de carril
        Serial.println("⏱️ C32: Tiempo en MANTENIENDO_CARRIL cumplido (" + 
                         String(tiempoEnManteniendo) + "ms). Iniciando cambio a carril 1.");
        carriles.carrilObjetivo = 1; 
        carriles.distanciaCarril1 = 25.0;
        controlLateral.ladoControl = 'D';
        cambiarEstado(EVALUANDO_POSICION); 
        return -1;
    } else {
        // Aún no ha pasado suficiente tiempo, seguir manteniendo
        Serial.print("⏳ C32: Avanzando en carril 2 antes del cambio... ");
        Serial.print(tiempoEnManteniendo);
        Serial.print("/");
        Serial.println(TIEMPO_AVANCE_MANTENIENDO_C32);
        // No retornar -1: dejar que el PID de pared siga controlando el servo
    }
  }
  if (carriles.esComandoC33 && carriles.carrilObjetivo == 1) {
       // Calcular cuánto tiempo llevamos en MANTENIENDO_CARRIL
    unsigned long tiempoEnManteniendo = millis() - carriles.tiempoInicioEstado;

    if (tiempoEnManteniendo >= TIEMPO_AVANCE_MANTENIENDO_C33) {
        // Ya avanzó suficiente, ahora sí proceder al cambio de carril
        Serial.println("⏱️ C33: Tiempo en MANTENIENDO_CARRIL cumplido (" + 
                         String(tiempoEnManteniendo) + "ms). Iniciando cambio a carril 1.");
        carriles.carrilObjetivo = 2; 
        carriles.distanciaCarril1 = 25.0;
        controlLateral.ladoControl = 'D';
        cambiarEstado(EVALUANDO_POSICION); 
        return -1;
    } else {
        // Aún no ha pasado suficiente tiempo, seguir manteniendo
        Serial.print("⏳ C33: Avanzando en carril 2 antes del cambio... ");
        Serial.print(tiempoEnManteniendo);
        Serial.print("/");
        Serial.println(TIEMPO_AVANCE_MANTENIENDO_C33);
        // No retornar -1: dejar que el PID de pared siga controlando el servo
    }
  }
  if (carriles.esComandoC14 && carriles.carrilObjetivo == 2) {
    // Calcular cuánto tiempo llevamos en MANTENIENDO_CARRIL
    unsigned long tiempoEnManteniendo = millis() - carriles.tiempoInicioEstado;

    if (tiempoEnManteniendo >= TIEMPO_AVANCE_MANTENIENDO_C14) {
        // Ya avanzó suficiente, ahora sí proceder al cambio de carril
        Serial.println("⏱️ C14: Tiempo en MANTENIENDO_CARRIL cumplido (" + 
                         String(tiempoEnManteniendo) + "ms). Iniciando cambio a carril 1.");
        carriles.carrilObjetivo = 1; controlLateral.ladoControl = 'D';
        cambiarEstado(EVALUANDO_POSICION); 
        return -1;
    } else {
        // Aún no ha pasado suficiente tiempo, seguir manteniendo
        Serial.print("⏳ C14: Avanzando en carril 2 antes del cambio... ");
        Serial.print(tiempoEnManteniendo);
        Serial.print("/");
        Serial.println(TIEMPO_AVANCE_MANTENIENDO_C14);
        // No retornar -1: dejar que el PID de pared siga controlando el servo
    }

  }
  if (carriles.esComandoC27 && carriles.carrilObjetivo == 1) {
    // Calcular cuánto tiempo llevamos en MANTENIENDO_CARRIL
    unsigned long tiempoEnManteniendo = millis() - carriles.tiempoInicioEstado;

    if (tiempoEnManteniendo >= TIEMPO_AVANCE_MANTENIENDO_C27) {
        // Ya avanzó suficiente, ahora sí proceder al cambio de carril
        Serial.println("⏱️ C27: Tiempo en MANTENIENDO_CARRIL cumplido (" + 
                         String(tiempoEnManteniendo) + "ms). Iniciando cambio a carril 2.");
        carriles.carrilObjetivo = 2;
        controlLateral.ladoControl = 'I';
        cambiarEstado(EVALUANDO_POSICION);
        return -1;
    } else {
        // Aún no ha pasado suficiente tiempo, seguir manteniendo
        Serial.print("⏳ C27: Avanzando en carril 1 antes del cambio... ");
        Serial.print(tiempoEnManteniendo);
        Serial.print("/");
        Serial.println(TIEMPO_AVANCE_MANTENIENDO_C27);
        // No retornar -1: dejar que el PID de pared siga controlando el servo
    }
  }

  return valorServo;
}
// ====================  FUNCIÓN DE CORRECCIÓN LATERAL POST-GIRO ====================
void ejecutarCorreccionDistanciaLateral() {
  if (!controlLateral_PostGiro.funcionActiva) {
    return;
  }

  unsigned long tiempoActual = millis();
  switch (controlLateral_PostGiro.estadoActual) {

    case ControlDistanciaLateral::IDLE: {

      // ── PAUSA DE ESTABILIZACIÓN: Detener y esperar 1s antes de leer ──
      // Se usa tiempoInicioEstado que ya se actualiza cada vez que
      // se entra a este estado, así el timer se resetea solo.
      detenerMotor();
      direccion.write(SERVO_CENTRADO);

      if (millis() - controlLateral_PostGiro.tiempoInicioEstado < 1000) {
        Serial.println("⏸️ Acomodo lateral: estabilizando 1s antes de medir...");
        break; // Salir y volver al loop, el motor ya está detenido
      }
      // ─────────────────────────────────────────────────────────────────

      float distanciaLateral;
      String ladoSensor;

      // 1. MEDIR LA DISTANCIA LATERAL
      if (sentidoVehiculo == DERECHA) {
        distanciaLateral = leerToF('I'); 
        ladoSensor = "izquierdo"; 
      } else {
        distanciaLateral = leerToF('D'); 
        ladoSensor = "derecho"; 
      }

      if (distanciaLateral == 999) break; 

      Serial.print("📏 CORRECCIÓN LATERAL - Distancia ");
      Serial.print(ladoSensor);
      Serial.print(": ");
      Serial.println(distanciaLateral, 1); 

      bool distanciaCorrecta = (distanciaLateral >= controlLateral_PostGiro.UMBRAL_MIN && distanciaLateral <= controlLateral_PostGiro.UMBRAL_MAX);

      if (!distanciaCorrecta) {
        // --- CASO A: LA DISTANCIA ES INCORRECTA ---
        // Se inicia el ciclo de corrección de distancia normal.
        float diferencia = 0.0;
        if (distanciaLateral < controlLateral_PostGiro.UMBRAL_MIN) {
          diferencia = controlLateral_PostGiro.UMBRAL_MIN - distanciaLateral; 
        } else if (distanciaLateral > controlLateral_PostGiro.UMBRAL_MAX) {
          diferencia = distanciaLateral - controlLateral_PostGiro.UMBRAL_MAX; 
        }

        if (diferencia >= 5.0) {
          controlLateral_PostGiro.tiempoCruceActual = 500; //800
          Serial.println("   -> Diferencia >= 6cm. Usando TIEMPO_CRUCE largo (700ms).");
        } else {
          controlLateral_PostGiro.tiempoCruceActual = 400; 
          Serial.println("   -> Diferencia < 6cm. Usando TIEMPO_CRUCE corto (450ms)."); 
        }
         // Si la diferencia es muy grande, activa la bandera para la maniobra de retroceso especial.
       /* if (diferencia > 16.0) {
          Serial.println("!!! Diferencia > 15cm. Se activará maniobra de retroceso orientado.");
          controlLateral_PostGiro.esCorreccionLarga = true;
        } else {
          controlLateral_PostGiro.esCorreccionLarga = false;
        }*/

        if (sentidoVehiculo == DERECHA) {
          if (distanciaLateral < controlLateral_PostGiro.UMBRAL_MIN) {
            Serial.println("⬇️ Muy cerca. Moviendo a la derecha."); 
            controlLateral_PostGiro.estadoActual = ControlDistanciaLateral::MOVIENDO_DERECHA;
            controlLateral_PostGiro.direccionManiobra = 'D';
            direccion.write(0);
          } else {
            Serial.println("⬆️ Muy lejos. Moviendo a la izquierda."); 
            controlLateral_PostGiro.estadoActual = ControlDistanciaLateral::MOVIENDO_IZQUIERDA;
            direccion.write(180);
            controlLateral_PostGiro.direccionManiobra = 'I';
          }
        } else { // Sentido IZQUIERDA
          if (distanciaLateral < controlLateral_PostGiro.UMBRAL_MIN) {
            Serial.println("⬇️ Muy cerca. Moviendo a la izquierda."); 
            controlLateral_PostGiro.estadoActual = ControlDistanciaLateral::MOVIENDO_IZQUIERDA;
            direccion.write(180);
            controlLateral_PostGiro.direccionManiobra = 'I';
          } else {
            Serial.println("⬆️ Muy lejos. Moviendo a la derecha."); 
            controlLateral_PostGiro.estadoActual = ControlDistanciaLateral::MOVIENDO_DERECHA;
            direccion.write(0);
            controlLateral_PostGiro.direccionManiobra = 'D';
          }
        }
        controlLateral_PostGiro.tiempoInicioEstado = tiempoActual;
        avanzarMotor();

      } else {
        // --- CASO B: LA DISTANCIA ES CORRECTA ---
        // Ahora realizamos la nueva verificación del ángulo.
        const float UMBRAL_ANGULO_FINAL = 5.0;
        float anguloObjetivoFinal = calcularAnguloRetroceso();
        float diferenciaAngular = calcularDiferenciaAngular(anguloZ, anguloObjetivoFinal);

        if (abs(diferenciaAngular) > UMBRAL_ANGULO_FINAL) {
          // El ángulo está desviado, se necesita una corrección corta.
          Serial.print("! Distancia OK, pero ángulo desviado > ");
          Serial.print(UMBRAL_ANGULO_FINAL);
          Serial.print("°. | Actual: ");
          Serial.print(anguloZ, 1);
          Serial.print("°, Objetivo: ");
          Serial.print(anguloObjetivoFinal, 1);
          Serial.println("°. Iniciando corrección corta.");

          // Usamos una duración de cruce corta y reiniciamos el ciclo de corrección
          controlLateral_PostGiro.tiempoCruceActual = 300; // 300ms de movimiento lateral

          // Si la diferencia es > 0, el robot apunta a la DERECHA del objetivo.
          // Nos movemos lateralmente a la IZQUIERDA para corregir.
          if (diferenciaAngular > 0) {
            controlLateral_PostGiro.estadoActual = ControlDistanciaLateral::MOVIENDO_IZQUIERDA;
            direccion.write(180); // Girar ruedas a la izquierda
          }
          // Si no, el robot apunta a la IZQUIERDA y nos movemos a la DERECHA.
          else {
            controlLateral_PostGiro.estadoActual = ControlDistanciaLateral::MOVIENDO_DERECHA;
            direccion.write(0); // Girar ruedas a la derecha
          }
          controlLateral_PostGiro.tiempoInicioEstado = tiempoActual;
          avanzarMotor();// Avanzar para iniciar la corrección

        } else {
          // ÉXITO: La distancia y el ángulo son correctos.
          Serial.println("✅ Distancia y ángulo correctos. Corrección finalizada.");
          controlLateral_PostGiro.funcionActiva = false;
          detenerMotor();
          direccion.write(SERVO_CENTRADO);
          cambiarEstado(ESPERANDO_COMANDO_CARRIL);
        }
      }
      break;
    }

    case ControlDistanciaLateral::MOVIENDO_DERECHA: {
      if (tiempoActual - controlLateral_PostGiro.tiempoInicioEstado >= controlLateral_PostGiro.tiempoCruceActual) {
        controlLateral_PostGiro.anguloObjetivo = calcularAnguloRetroceso(); 
        Serial.print("⏱️ Tiempo de cruce DERECHA finalizado. Corrigiendo ángulo hacia: "); 
        Serial.println(controlLateral_PostGiro.anguloObjetivo); 
        controlLateral_PostGiro.estadoActual = ControlDistanciaLateral::CORRIGIENDO_ANGULO_IZQUIERDA;
        direccion.write(170); 
      }
      break;
    }

    case ControlDistanciaLateral::MOVIENDO_IZQUIERDA: {
      if (tiempoActual - controlLateral_PostGiro.tiempoInicioEstado >= controlLateral_PostGiro.tiempoCruceActual) {
        controlLateral_PostGiro.anguloObjetivo = calcularAnguloRetroceso(); 
        Serial.print("⏱️ Tiempo de cruce IZQUIERDA finalizado. Corrigiendo ángulo hacia: "); 
        Serial.println(controlLateral_PostGiro.anguloObjetivo); 
        controlLateral_PostGiro.estadoActual = ControlDistanciaLateral::CORRIGIENDO_ANGULO_DERECHA;
        direccion.write(10); 
      }
      break;
    }

    case ControlDistanciaLateral::CORRIGIENDO_ANGULO_DERECHA:
    case ControlDistanciaLateral::CORRIGIENDO_ANGULO_IZQUIERDA: {
      avanzarLento(); // Velocidad reducida durante el enderezado de ángulo
      // ===== LÓGICA DE INTERRUPCIÓN Y CONTINUACIÓN =====
      float distanciaFrontal = leerToF('F');
      if (distanciaFrontal <= 13 && distanciaFrontal > 0) {
        Serial.println("! OBSTÁCULO FRONTAL durante contra-giro !");
        Serial.println("  -> Pausando, retrocediendo 1 seg y continuando...");

        // 1. Pausar el avance y enderezar las ruedas temporalmente
        detenerMotor();
        direccion.write(SERVO_CENTRADO);
        delay(100);

        // 2. Retroceder por 1 segundo mientras se actualiza el ángulo
        retrocederMotor();
        unsigned long tiempoInicioRetroceso = millis();
        while (millis() - tiempoInicioRetroceso < 700) {
          actualizarGiro();
          delay(10);
        }
        detenerMotor();
        delay(100);

        // 3. Reanudar el contra-giro exactamente como estaba
        if (controlLateral_PostGiro.estadoActual == ControlDistanciaLateral::CORRIGIENDO_ANGULO_DERECHA) {
            Serial.println("  -> Reanudando contra-giro a la DERECHA.");
            direccion.write(0); // Vuelve a girar las ruedas para la corrección
        } else { // Es CORRIGIENDO_ANGULO_IZQUIERDA
            Serial.println("  -> Reanudando contra-giro a la IZQUIERDA.");
            direccion.write(180); // Vuelve a girar las ruedas para la corrección
        }
        avanzarLento();// Reanuda el avance
      }
      // ==========
      float anguloActual = anguloZ; 
      float diferenciaAngular = abs(anguloActual - controlLateral_PostGiro.anguloObjetivo);
      if (diferenciaAngular > 180) {
        diferenciaAngular = 360 - diferenciaAngular; 
      }

      if (diferenciaAngular <= controlLateral_PostGiro.TOLERANCIA_ANGULAR) {
        Serial.println("🎯 Ángulo corregido. Iniciando retroceso."); 
        controlLateral_PostGiro.estadoActual = ControlDistanciaLateral::RETROCEDIENDO_FINAL;
        detenerMotor();
        delay(100);
         if (controlLateral_PostGiro.esCorreccionLarga) {
          Serial.println("🎯 Ángulo corregido. Iniciando RETROCESO ORIENTADO.");
          controlLateral_PostGiro.estadoActual = ControlDistanciaLateral::RETROCEDIENDO_ORIENTADO;
        } else {
          Serial.println("🎯 Ángulo corregido. Iniciando RETROCESO FINAL (recto).");
          controlLateral_PostGiro.estadoActual = ControlDistanciaLateral::RETROCEDIENDO_FINAL;
          retrocederMotor();
          direccion.write(SERVO_CENTRADO);
        }
        controlLateral_PostGiro.tiempoInicioEstado = millis();
      }
      break;
    }
    case ControlDistanciaLateral::RETROCEDIENDO_ORIENTADO: {
      // 1. Apuntar en la dirección original de la maniobra
      if (controlLateral_PostGiro.direccionManiobra == 'D') {
        direccion.write(0); // Misma dirección que MOVIENDO_DERECHA
      } else {
        direccion.write(180); // Misma dirección que MOVIENDO_IZQUIERDA
      }

      // 2. Retroceder por 500ms
      retrocederMotor();

      // 3. Después de 500ms, pasar a la fase de corrección en retroceso
      if (tiempoActual - controlLateral_PostGiro.tiempoInicioEstado >= 800) {
        Serial.println("⏱️ 500ms de retroceso orientado completados. Invirtiendo dirección.");
        controlLateral_PostGiro.estadoActual = ControlDistanciaLateral::CORRIGIENDO_POST_RETROCESO;
        controlLateral_PostGiro.anguloObjetivo = calcularAnguloRetroceso(); // Re-calcular por si acaso
      }
      break;
    }
    case ControlDistanciaLateral::CORRIGIENDO_POST_RETROCESO: {
      // 1. Apuntar en la dirección CONTRARIA (contra-giro)
      if (controlLateral_PostGiro.direccionManiobra == 'D') {
        direccion.write(180); // Contra-giro
      } else {
        direccion.write(0); // Contra-giro
      }

      // 2. Continuar retrocediendo y monitorear el ángulo
      retrocederMotor();
      float anguloActual = anguloZ;
      float diferenciaAngular = abs(anguloActual - controlLateral_PostGiro.anguloObjetivo);
      if (diferenciaAngular > 180) {
        diferenciaAngular = 360 - diferenciaAngular;
      }

      // 3. Cuando el ángulo sea correcto, enderezar ruedas y pasar al retroceso final
      if (diferenciaAngular <= controlLateral_PostGiro.TOLERANCIA_ANGULAR) {
        Serial.println("🎯 Ángulo enderezado en retroceso. Pasando a retroceso final.");
        direccion.write(SERVO_CENTRADO);
        controlLateral_PostGiro.estadoActual = ControlDistanciaLateral::RETROCEDIENDO_FINAL;
      }
      break;
    }
    case ControlDistanciaLateral::RETROCEDIENDO_FINAL: {
      retrocederMotor();
        direccion.write(SERVO_CENTRADO);
      float distanciaTrasera = leerToF('T'); 
      if (distanciaTrasera == 999) break;

      if (distanciaTrasera < controlLateral_PostGiro.DISTANCIA_TRASERA_OBJETIVO) {
        Serial.print("🏁 Retroceso finalizado. Distancia trasera:"); 
        Serial.println(distanciaTrasera); 
        Serial.print("🏁 Re-evaluando posición lateral y angular.");
        detenerMotor();
        controlLateral_PostGiro.estadoActual = ControlDistanciaLateral::IDLE;// Vuelve a evaluar
        controlLateral_PostGiro.tiempoInicioEstado = millis(); // Reset timer para nueva evaluación
        controlLateral_PostGiro.esCorreccionLarga = false;
      }
      break;
    }
  }
}
float calcularControlCarriles() {
  switch (estadoActual) { // Usa la variable global 'estadoActual'
    case ESPERANDO_COMANDO_CARRIL: // Usa el nombre correcto del enum
      return procesarEstadoEsperandoComando();
      
    case EVALUANDO_POSICION:
      return procesarEstadoEvaluandoPosicion();
      
    case GIRANDO_HACIA_CARRIL:
      return procesarEstadoGirandoHaciaCarril();
      
    case ENDEREZANDO_CARRIL:
      return procesarEstadoEnderezandoCarril();

    case MANTENIENDO_CARRIL: {
      float resultado = procesarMantenimientoPared();
      // Si es -1, significa que no se debe cambiar la dirección
      if (resultado == -1) {
        return -1;  // Propagar el valor especial
      }
      return resultado;
    }

      
    default:
      return 90.0;
  }
}

void procesarComandoCarril(String comando) {
  int carrilAnterior = carriles.carrilObjetivo;
  // VERDE se esquiva por la izquierda. y posicionado a la izquierda **apartir del 13 son dobles verdes
  if ( comando == "C07" || comando == "C09" || comando == "C13" || comando == "C37" ||  comando == "C19"|| comando == "C31") {
    carriles.esComandoC07 = true;
    carriles.carrilObjetivo = 2;
    carriles.distanciaCarril2 = 18.0; // Restablece la distancia al valor por defecto
    carriles.esComandoC21 = false;
    // Modo distancia solo para C07 con sentido IZQUIERDA (giro a carril 2)
      if (comando == "C07" || comando == "C09" || comando == "C13" || comando == "C37" && sentidoVehiculo == IZQUIERDA) {
        carriles.esComandoC07ModoDistancia = true;
        // Medir distancia derecha y calcular tiempo de giro proporcional
        float distTof = leerToF('D');
        // Clampear entre 30cm (máx tiempo) y 65cm (mín tiempo)
        float distClamped = constrain(distTof, 30.0, 65.0);
        // Interpolación lineal: 30cm → 1800ms, 65cm → 800ms
        //float tiempoCalculado = 1300.0 - ((distClamped - 30.0) / (65.0 - 30.0)) * (1300.0 - 500.0);

        float tiempoC01 = 1600.0 - ((distClamped - 30.0) / (65.0 - 30.0)) * (1600.0 - 600.0);
        carriles.tiempoGiroCarril2 = (unsigned long)tiempoC01;
        Serial.println("🎯 C01 Modo Distancia: ToF D=" + String(distTof, 1) +
                        "cm → Tiempo giro=" + String((unsigned long)tiempoC01) + "ms");
      } else {
        carriles.esComandoC07ModoDistancia = false;
      }
  
  //  Casaos Verde a la derecha. **apartir del 13 son dobles verdes **apartir del 25 son dobles verdes 
  } else if (comando == "C01" || comando == "C03"|| comando == "C05"|| comando == "C25") {
    carriles.esComandoC01 = true;
    carriles.carrilObjetivo = 2;
    carriles.distanciaCarril2 = 20.0;
    carriles.esComandoC21 = false;

    // Modo distancia solo para C01 con sentido IZQUIERDA (giro a carril 2)
    if (comando == "C01" || comando == "C03"|| comando == "C05"|| comando == "C25" && sentidoVehiculo == IZQUIERDA) {
      carriles.esComandoC01ModoDistancia = true;
      // Medir distancia derecha y calcular tiempo de giro proporcional
      float distTof = leerToF('D');
      // Clampear entre 30cm (máx tiempo) y 65cm (mín tiempo)
      float distClamped = constrain(distTof, 30.0, 65.0);
      // Interpolación lineal: 30cm → 1800ms, 65cm → 800ms
      float tiempoC01 = 1100.0 - ((distClamped - 30.0) / (65.0 - 30.0)) * (1100.0 - 300.0);
      carriles.tiempoGiroCarril2 = (unsigned long)tiempoC01;
      Serial.println("🎯 C01 Modo Distancia: ToF D=" + String(distTof, 1) +
                       "cm → Tiempo giro=" + String((unsigned long)tiempoC01) + "ms");
    } else {
      carriles.esComandoC01ModoDistancia = false;
    }

  // Comando especial C21 - primero va a carril 1, luego a carril 2
  } else if (comando == "C21") {
    carriles.carrilObjetivo = 1;    // Primero ir a carril 1
    carriles.esComandoC21 = true;   // Marcar como comando especial
    // ── NUEVO: Tiempo dinámico por distancia ──
    if (sentidoVehiculo == DERECHA) {
      float distTof = leerToF('I');
      float distClamped = constrain(distTof, 30.0, 65.0);
      float tiempoCalculado = 1500.0 - ((distClamped - 30.0) / (65.0 - 30.0)) * (1500.0 - 600.0);
      carriles.tiempoGiroCarril1 = (unsigned long)tiempoCalculado;
      Serial.println("🎯 C21 Modo Distancia: ToF D=" + String(distTof, 1) +
                       "cm → Tiempo giro=" + String((unsigned long)tiempoCalculado) + "ms");
    }
    Serial.println("🔄 Comando C21: A Carril 1, luego a Carril 2.");  // C27 Rojo, Adelante Derecha y Verde, Atrás Derecha
  }else if (comando == "C27") { 
    carriles.carrilObjetivo = 1;      // 1. El primer objetivo es el carril 1.
    carriles.esComandoC27 = true;      // 2. Activamos el flag especial para C27.
    // 3. Nos aseguramos de que los otros flags estén desactivados.
    carriles.esComandoC21 = false;
    carriles.esComandoC14 = false;
    carriles.esComandoC15 = false;
    carriles.esComandoC20 = false;
    // Tiempo dinámico por distancia ──
    if (sentidoVehiculo == DERECHA) {
      float distTof = leerToF('I');
      float distClamped = constrain(distTof, 30.0, 65.0);
      float tiempoCalculado = 1500.0 - ((distClamped - 30.0) / (65.0 - 30.0)) * (1500.0 - 600.0);
      carriles.tiempoGiroCarril1 = (unsigned long)tiempoCalculado;
      Serial.println("🎯 C27 Modo Distancia: ToF I=" + String(distTof, 1) +
                       "cm → Tiempo giro=" + String((unsigned long)tiempoCalculado) + "ms");
    }
    Serial.println("🔄 Comando C27: A Carril 1, luego a Carril 2.");
  // Comando especial C15 - primero va a carril 2, luego a carril 1
  } else if (comando == "C15") { 
    carriles.carrilObjetivo = 1;      // 1. El primer objetivo es el carril 1.
    carriles.esComandoC15 = true;     // 2. Activamos el flag especial para C15.
    carriles.esComandoC21 = false;    // 3. Nos aseguramos de que los otros flags estén desactivados.
    carriles.esComandoC14 = false;
    Serial.println("🔄 Comando C15: A Carril 1 (40°), luego a Carril 2 (140°).");
    // ── NUEVO: Tiempo dinámico por distancia ──
    if (sentidoVehiculo == DERECHA) {
      float distTof = leerToF('I');
      float distClamped = constrain(distTof, 30.0, 65.0);
      float tiempoCalculado = 800.0 - ((distClamped - 30.0) / (65.0 - 30.0)) * (800.0 - 300.0);
      carriles.tiempoGiroCarril1 = (unsigned long)tiempoCalculado;
      Serial.println("🎯 C15 Modo Distancia: ToF I=" + String(distTof, 1) +
                       "cm → Tiempo giro=" + String((unsigned long)tiempoCalculado) + "ms");
    }
  }  else if (comando == "C14") {
    carriles.carrilObjetivo = 2;    // Primero ir a carril 2
    carriles.esComandoC14 = true;   // Marcar como comando especial
    carriles.esComandoC21 = false;  // Resetear flag C21
    // ── NUEVO: Tiempo dinámico por distancia ──
    if (sentidoVehiculo == IZQUIERDA) {
      float distTof = leerToF('D');
      float distClamped = constrain(distTof, 30.0, 65.0);
      float tiempoCalculado = 1300.0 - ((distClamped - 30.0) / (65.0 - 30.0)) * (1300.0 - 500.0);
      carriles.tiempoGiroCarril2 = (unsigned long)tiempoCalculado;
      Serial.println("🎯 C14 Modo Distancia: ToF D=" + String(distTof, 1) +
                       "cm → Tiempo giro=" + String((unsigned long)tiempoCalculado) + "ms");
    }
    Serial.println("🔄 Comando C14: Primero carril 2, luego carril 1 automáticamente");
  
  // Comandos para carril 1  DERECHA COMANDOS PARA ROJO. rojos a la derecha.
  }else if (comando == "C32") {
    carriles.carrilObjetivo = 2;      // 1. The first target is lane 1.
    carriles.esComandoC32 = true;       // 2. Activate the special flag for C33.
    // 3. Make sure other special flags are disabled.
    carriles.esComandoC21 = false;
    carriles.esComandoC14 = false;
    carriles.esComandoC15 = false;
    carriles.esComandoC20 = false;
    carriles.esComandoC26 = false;
    if (sentidoVehiculo == IZQUIERDA) {
      float distTof = leerToF('D');
      float distClamped = constrain(distTof, 30.0, 65.0);
      float tiempoCalculado = 1300.0 - ((distClamped - 30.0) / (65.0 - 30.0)) * (1300.0 - 500.0);
      carriles.tiempoGiroCarril2 = (unsigned long)tiempoCalculado;
      Serial.println("🎯 C32 Modo Distancia: ToF D=" + String(distTof, 1) +
                       "cm → Tiempo giro=" + String((unsigned long)tiempoCalculado) + "ms");
    }
    Serial.println("🔄 Comando C32: A Carril 2 (160°), luego a Carril 1 (20°).");
  // Comandos para carril 1  DERECHA COMANDOS PARA ROJO. rojos a la derecha.
  }  else if (comando == "C20") { 
    carriles.carrilObjetivo = 2;      // 1. El primer objetivo es el carril 2.
    carriles.distanciaCarril2 = 35.0;
    carriles.esComandoC20 = true;     // 2. Activamos el flag especial para C20.
    carriles.esComandoC21 = false;    // 3. Nos aseguramos de que los otros flags estén desactivados.
    carriles.esComandoC14 = false;
    carriles.esComandoC15 = false;
    
    Serial.println("🔄 Comando C20: A Carril 2 (140°), luego a Carril 1 (40°).");
    // ── NUEVO: Tiempo dinámico por distancia ──
    if (sentidoVehiculo == IZQUIERDA) {
      float distTof = leerToF('D');  
      float distClamped = constrain(distTof, 30.0, 65.0);
      float tiempoCalculado = 800.0 - ((distClamped - 30.0) / (65.0 - 30.0)) * (800.0 - 300.0);
      carriles.tiempoGiroCarril1 = (unsigned long)tiempoCalculado;
      Serial.println("🎯 C20 Modo Distancia: ToF D=" + String(distTof, 1) +
                       "cm → Tiempo giro=" + String((unsigned long)tiempoCalculado) + "ms");
    }
  } else if (comando == "C26") { 
    carriles.carrilObjetivo = 2;      // 1. El primer objetivo es el carril 2.
    carriles.esComandoC26 = true;      // 2. Activamos el flag especial para C26.
    // 3. Nos aseguramos de que los otros flags estén desactivados.
    carriles.esComandoC21 = false;
    carriles.esComandoC14 = false;
    carriles.esComandoC15 = false;
    carriles.esComandoC20 = false;
    // ── NUEVO: Tiempo dinámico por distancia ──
    if (sentidoVehiculo == IZQUIERDA) {
      float distTof = leerToF('D');
      float distClamped = constrain(distTof, 30.0, 65.0);
      float tiempoCalculado = 1300.0 - ((distClamped - 30.0) / (65.0 - 30.0)) * (1300.0 - 400.0);
      carriles.tiempoGiroCarril1 = (unsigned long)tiempoCalculado;
      Serial.println("🎯 C26 Modo Distancia: ToF D=" + String(distTof, 1) +
                       "cm → Tiempo giro=" + String((unsigned long)tiempoCalculado) + "ms");
    }
    Serial.println("🔄 Comando C26: A Carril 2 (140°), luego a Carril 1 (20°).");

  } else if (comando == "C33") {
    carriles.carrilObjetivo = 1;      
    carriles.esComandoC33 = true;       
    carriles.esComandoC21 = false;
    carriles.esComandoC14 = false;
    carriles.esComandoC15 = false;
    carriles.esComandoC20 = false;
    carriles.esComandoC26 = false;
    Serial.println("🔄 Comando C33: To Lane 1 (20°), then to Lane 2 (140°).");
    // ── NUEVO: Tiempo dinámico por distancia ──
    if (sentidoVehiculo == DERECHA) {
      float distTof = leerToF('I');
      float distClamped = constrain(distTof, 30.0, 65.0);
      float tiempoCalculado = 800.0 - ((distClamped - 30.0) / (65.0 - 30.0)) * (800.0 - 300.0);
      carriles.tiempoGiroCarril1 = (unsigned long)tiempoCalculado;
      Serial.println("🎯 C33 Modo Distancia: ToF I=" + String(distTof, 1) +
                       "cm → Tiempo giro=" + String((unsigned long)tiempoCalculado) + "ms");
    }

  } else if (comando == "C02" || comando == "C04"  ||comando == "C06" ||comando == "C18"||comando == "C24"||comando == "C30") {
    carriles.carrilObjetivo = 1;
    carriles.esComandoC02 = true;
    carriles.distanciaCarril1 = 10.0; 
    carriles.esComandoC21 = false;  // Resetear flag 
      // Modo distancia solo para C07 con sentido IZQUIERDA (giro a carril 2)
      if (comando == "C02" || comando == "C04"  ||comando == "C06" ||comando == "C18"||comando == "C24"||comando == "C30" && sentidoVehiculo == DERECHA) {
        carriles.esComandoC02ModoDistancia = true;
        carriles.distanciaCarril2 = 38.0; 
        // Medir distancia derecha y calcular tiempo de giro proporcional
        float distTof = leerToF('I');
        // Clampear entre 30cm (máx tiempo) y 65cm (mín tiempo)
        float distClamped = constrain(distTof, 30.0, 65.0);
        // Interpolación lineal: 30cm → 1800ms, 65cm → 800ms
        float tiempoC01 = 1600.0 - ((distClamped - 30.0) / (65.0 - 30.0)) * (1500.0 - 600.0);
        carriles.tiempoGiroCarril2 = (unsigned long)tiempoC01;
        Serial.println("🎯 C01 Modo Distancia: ToF I=" + String(distTof, 1) +
                        "cm → Tiempo giro=" + String((unsigned long)tiempoC01) + "ms");
      } else {
        carriles.esComandoC02ModoDistancia = false;
      }
    
  //  Casaos Rojos a la izquierda. mayor distancia con la pared. 
  } else if (comando == "C08" || comando == "C10"||comando == "C38"||comando == "C36") {
    carriles.esComandoC08 = true;
    carriles.carrilObjetivo = 1;
    carriles.distanciaCarril1 = 20.0; // Cambia la distancia solo para este comando
    carriles.esComandoC21 = false;
      // Modo distancia solo para C01 con sentido IZQUIERDA (giro a carril 2)
    if (comando == "C08" || comando == "C10"||comando == "C38"||comando == "C36" && sentidoVehiculo == DERECHA) {
      carriles.esComandoC08ModoDistancia = true;
      // Medir distancia derecha y calcular tiempo de giro proporcional
      float distTof = leerToF('I');
      // Clampear entre 30cm (máx tiempo) y 65cm (mín tiempo)
      float distClamped = constrain(distTof, 30.0, 65.0);
      // Interpolación lineal: 30cm → 1800ms, 65cm → 800ms
      float tiempoC01 = 1100.0 - ((distClamped - 30.0) / (65.0 - 30.0)) * (1100.0 - 300.0);
      carriles.tiempoGiroCarril2 = (unsigned long)tiempoC01;
      Serial.println("🎯 C01 Modo Distancia: ToF D=" + String(distTof, 1) +
                       "cm → Tiempo giro=" + String((unsigned long)tiempoC01) + "ms");
    } else {
      carriles.esComandoC08ModoDistancia = false;
    }

  // Comando especial C21 - primero va a carril 1, luego a carril 2
  }  else {
    Serial.println(" Comando no reconocido: " + comando);
    return;
  }
   if (carriles.carrilObjetivo == 2) {
      carriles.direccionGiro = -1.0; // Valor negativo para giro a la IZQUIERDA
      Serial.println("   -> Dirección de giro establecida a: IZQUIERDA");
     //  Destello Verde por 400ms (No bloqueante)
      encenderLedTemporal(0, 255, 0, 400);
  } else if (carriles.carrilObjetivo == 1) {
      carriles.direccionGiro = 1.0; // Valor positivo para giro a la DERECHA
      Serial.println("   -> Dirección de giro establecida a: DERECHA");
     // Destello Rojo por 400ms (No bloqueante)
      encenderLedTemporal(255, 0, 0, 400);
  }
  // CAMBIO PRINCIPAL: Inicia el cooldown de detección de líneas INMEDIATAMENTE.
  // Esto evita que se detecte una línea mientras se evalúa la posición, antes de empezar el giro.
  tiempoUltimaDeteccion = millis();
  Serial.println("COOLDOWN DE DETECCIÓN DE LÍNEAS ACTIVADO INMEDIATAMENTE.");

  Serial.println(" Comando recibido: " + comando + " → Carril " + String(carriles.carrilObjetivo));
  
  // Si es el primer giro (y es uno de los comandos de inicio), salta directo a la acción
  if (!primerGiroRealizado && (comando == "C01" || comando == "C02" || comando == "C07" || comando == "C08")) {
    Serial.println(">>> PRIMER GIRO: Saltando evaluación, yendo directo a GIRANDO_HACIA_CARRIL.");
    cambiarEstado(GIRANDO_HACIA_CARRIL); 
  } 
  // Para cualquier otro caso, sigue la lógica normal
  else if (carrilAnterior != carriles.carrilObjetivo || estadoActual == ESPERANDO_COMANDO_CARRIL) { 
    cambiarEstado(EVALUANDO_POSICION); 
  }
}
void resetSistema(bool conservarAngulo = true) {
  // Reset de variables de control lateral
  controlLateral.integralDistancia = 0;
  controlLateral.errorDistanciaAnterior = 0;
  controlLateral.filtroIzquierda.inicializar();
  controlLateral.filtroDerecha.inicializar();

  // Reset de flags de comandos especiales
  carriles.esComandoC21 = false;
  carriles.esComandoC14 = false;

  // Reset de estado del sistema de carriles
  carriles.carrilObjetivo = 1;
  carriles.ladoControl = 'D';
  estadoActual = ESTADO_NORMAL; // Asigna a la variable global 'estadoActual'
  carriles.tiempoInicioEstado = millis();
  carriles.necesitaCambio = false;

  // Recentrar servo
 // direccion.write(90);

  Serial.println("🔄 Sistema reseteado" + String(conservarAngulo ? " (ángulo conservado)" : " (ángulo reiniciado)"));
}
// Función auxiliar para generar pulsos cortos (volumen bajo)
void buzzerVolumenBajo(int duracionTotal) {
  int tiempoTranscurrido = 0;
  while (tiempoTranscurrido < duracionTotal) {
    tone(BUZZER_PIN, 1500); // Enciende el tono
    delay(100); 
    noTone(BUZZER_PIN);     // Apaga el tono
    delay(20); 
    tiempoTranscurrido += 120;
  }
}

void esperarInterruptor() {
  ////ln(F("Esperando activacion del interruptor (LOW)..."));
  
  // LED parpadea lentamente mientras espera
  bool ledState = false;
  unsigned long ultimoParpadeo = 0;

  
  while (digitalRead(INTERRUPTOR_PIN) == HIGH) {  // Espera a que pase a LOW
    unsigned long ahora = millis();
    
    // Parpadeo lento del LED (cada 500ms)
    if (ahora - ultimoParpadeo > 500) {
      ledState = !ledState;
      colorVehiculo(255, 100, 0);
      ultimoParpadeo = ahora;
    }
    
    delay(10);
  }
  
  // Cuando el interruptor pasa a LOW, activar sistema
  apagarVehiculo(); // Apagar LED de espera
  delay(50); // Pequeña pausa para debounce
  iniciarSistema();
} 
  // Función mejorada para verificar el interruptor y controlar el sistema
void verificarInterruptor() {
  bool estadoActual = digitalRead(INTERRUPTOR_PIN);
  unsigned long tiempoActual = millis();
  
  // Debounce del interruptor
  if (estadoActual != interruptorAnterior) {
    tiempoDebounce = tiempoActual;
  }
  
  if ((tiempoActual - tiempoDebounce) > DEBOUNCE_DELAY) {
    if (estadoActual != interruptorAnterior) {
      // Cambio de estado confirmado
      if (estadoActual == LOW) {
        // Interruptor en LOW - INICIAR SISTEMA
        if (!sistemaActivo) {
          iniciarSistema();
        }
      } else {
        // Interruptor en HIGH - DETENER SISTEMA
        if (sistemaActivo) {
          detenerSistema();
        }
      }
      interruptorAnterior = estadoActual;
    }
  }
}
// LED indicador de sistema activo - 3 parpadeos rápidos con sonido
void indicadorSistemaActivo() {
  for (int i = 0; i < 3; i++) {
    colorVehiculo(255, 0, 200);
 //   buzzerVolumenBajo(100);  // 100ms con pulsos cortos
    apagarVehiculo();
    delay(100);
  }
}
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
void loop() {

  // PRIMERA PRIORIDAD: Verificar interruptor SIEMPRE
  verificarInterruptor();
  
  verificarArranqueMotor();

  // Si el sistema no está activo, no ejecutar nada más
  if (!sistemaActivo) {
    delay(50);  // Pequeña pausa para no saturar el procesador
    return;
  }
  
  // ────────────────────────────────────────────────────────────────────────
  
    // Procesar giro de apertura si está activo
  if (giroAperturaActivo) {
    procesarGiroApertura();
    return; // No ejecutar nada más mientras se procesa la apertura
  }
    // EJECUTAR SIEMPRE (independiente de comandos seriales)
  actualizarGiro();
  actualizarLedTemporal(); //  Vigila los LEDs sin bloquear
    // Detección de color se ejecuta en estados de navegación, no durante maniobras de carril
  // (La interrupción ya se maneja dentro de los casos del switch)
  /*if (estadoActual == ESTADO_NORMAL) {
      detectarColor();
  }*/
 /*if (estadoActual != ESTADO_DETENCION_FINAL){
    detectarColor();
  }*/
   // MÁQUINA DE ESTADOS - Solo ejecutar si no hay procesos de alta prioridad
  switch(estadoActual) {
    case ESTADO_NORMAL:
      //centrarVehiculo();
           if (!enGiro && 
          prioridadActual == PRIORIDAD_NORMAL && 
          !esquiveDiagonalActivo && 
          !retrocesoPorEmergencia &&
          !retrocesoOrientadoActivo) { 
        centrarVehiculo();
      }
      break;
    case ESPERANDO_COMANDO_CARRIL:
      detenerMotor();

      // Buffer acumulador para armar el comando carácter a carácter
      while (Serial.available() > 0) {
        char c = Serial.read();
        if (c == '\n' || c == '\r') {
          if (bufferIndex > 0) {
            buffer[bufferIndex] = '\0';
            comandoRecibido = String(buffer);
            comandoListo = true;
            bufferIndex = 0;
          }
        } else if (bufferIndex < BUFFER_SIZE - 1) {
          buffer[bufferIndex++] = c;
        }
      }

      if (comandoListo) {
        comandoListo = false;
        comandoRecibido.trim();

        comandoRecibido.toUpperCase();
        if (comandoRecibido.startsWith("C") && comandoRecibido.length() >= 3) {
          comandoRecibido = comandoRecibido.substring(0, 3);
          Serial.println("Comando aceptado: " + comandoRecibido);
          Serial.println("Comando aceptado: " + comandoRecibido);
          procesarComandoCarril(comandoRecibido);
        } else {
          Serial.println("Comando ignorado: " + comandoRecibido);
        }
      }

      // Reporte de sensores cada 1000ms (sin bloquear)
      static unsigned long ultimoReporteEspera = 0;
      if (millis() - ultimoReporteEspera > 1000) {
        float distF = leerToF('F');
        float distI = leerToF('I');
        float distD = leerToF('D');
        float distSharpIzq = leerSensorSharp(SHARP_DIAGONAL_IZQ_PIN);
        float distSharpDer = leerSensorSharp(SHARP_DIAGONAL_DER_PIN);
        Serial.print("⏸️ ESTADO ESPERA | ToF F: ");
        Serial.print(distF > 0 && distF < 999 ? String(distF, 1) + "cm" : "N/A");
        Serial.print(" | ToF I: ");
        Serial.print(distI > 0 && distI < 999 ? String(distI, 1) + "cm" : "N/A");
        Serial.print(" | ToF D: ");
        Serial.print(distD > 0 && distD < 999 ? String(distD, 1) + "cm" : "N/A");
        Serial.print(" | Sharp Izq: ");
        Serial.print(distSharpIzq > 0 && distSharpIzq < 150 ? String(distSharpIzq, 1) + "cm" : "N/A");
        Serial.print(" | Sharp Der: ");
        Serial.println(distSharpDer > 0 && distSharpDer < 150 ? String(distSharpDer, 1) + "cm" : "N/A");
        ultimoReporteEspera = millis();
      }

      break;

     case EVALUANDO_POSICION:
    case GIRANDO_HACIA_CARRIL:
    case ENDEREZANDO_CARRIL:
    case MANTENIENDO_CARRIL:
      { 
        EstadoSistema estadoPrevio = estadoActual; // Guardar el estado actual

        // Durante todos los estados de carril, permitir interrupción por línea
        //detectarColor(); // 

        // Si detectarColor cambió el estado, significa que encontró una línea
        // y comenzó un giro. Debemos salir del switch INMEDIATAMENTE.
       /* if (estadoActual != estadoPrevio) {
            break; 
        }*/

        // Si no hubo cambio de estado, continuar con la lógica de carriles
        if (millis() - ultimaActualizacionf >= INTERVALO_CONTROLf) {
            float anguloServo = calcularControlCarriles(); // 
            if (anguloServo != -1) {
                direccion.write((int)anguloServo); // 
                
               if (millis() - ultimoReportef > INTERVALO_REPORTEf) {
                    float distSharpIzqR = leerSensorSharp(SHARP_DIAGONAL_IZQ_PIN);
                    float distSharpDerR = leerSensorSharp(SHARP_DIAGONAL_DER_PIN);
                    Serial.print("Servo: ");
                    Serial.print((int)anguloServo);
                    Serial.print(" | Carril: ");
                    Serial.print(carriles.carrilObjetivo);
                    Serial.print(" | Lado: ");
                    Serial.print(controlLateral.ladoControl);
                    Serial.print(" | Err Dist: ");
                    Serial.print(controlLateral.errorDistanciaAnterior, 2);
                    Serial.print(" | Err Ang: ");
                    float errorAngulo = controlLateral.anguloObjetivo - anguloZ;
                    if (errorAngulo > 180.0) errorAngulo -= 360.0;
                    else if (errorAngulo < -180.0) errorAngulo += 360.0;
                    Serial.print(errorAngulo, 1);
                    Serial.print(" | Sharp Izq: ");
                    Serial.print(distSharpIzqR > 0 && distSharpIzqR < 150 ? String(distSharpIzqR, 1) + "cm" : "N/A");
                    Serial.print(" | Sharp Der: ");
                    Serial.print(distSharpDerR > 0 && distSharpDerR < 150 ? String(distSharpDerR, 1) + "cm" : "N/A");
                    Serial.println();
                    ultimoReportef = millis();
                }
            }
            if (enFaseContragiro) {
                avanzarLento(); // Lento solo durante el contragiro de enderezado
            } else {
                avanzarMotor(); // Velocidad normal para todo lo demás
            }
            ultimaActualizacionf = millis();
        }
      } 
      break;
   /* float anguloServo = calcularControlCarriles();
    if (anguloServo != -1) {
        direccion.write((int)anguloServo);

        // ====== INICIO: NUEVO MONITOR DE DEPURACIÓN ======
        // Este bloque imprimirá solo cuando esté en el estado de mantenimiento de carril
        if (millis() - ultimoReportef > INTERVALO_REPORTEf) {
            Serial.print("Servo: ");
            Serial.print((int)anguloServo);
            Serial.print(" | Carril: ");
            Serial.print(carriles.carrilObjetivo);
            Serial.print(" | Lado: ");
            Serial.print(controlLateral.ladoControl);
            Serial.print(" | Err Dist: ");
            Serial.print(controlLateral.errorDistanciaAnterior, 2); // Muestra el último error de distancia calculado
            Serial.print(" | Err Ang: ");
            float errorAngulo = controlLateral.anguloObjetivo - anguloZ;
            if (errorAngulo > 180.0) errorAngulo -= 360.0;
            else if (errorAngulo < -180.0) errorAngulo += 360.0;
            Serial.print(errorAngulo, 1);
            Serial.println();
            ultimoReportef = millis();
        }
        // ====== FIN: NUEVO MONITOR DE DEPURACIÓN ======
    }
    avanzarMotor();
    ultimaActualizacionf = millis();
    }
      break;
*/
    case ESTADO_CORRECCION_LATERAL:
      ejecutarCorreccionDistanciaLateral();
      break;
    case ESTADO_DETENCION_FINAL:
     if (contadorEntradaEstadoFinal >= 1){
      /*  analogWrite(BUZZER_PIN, 255);
        delay(50);
        analogWrite(BUZZER_PIN, 0);
        delay(50);
        analogWrite(BUZZER_PIN, 255);
        delay(50);
        analogWrite(BUZZER_PIN, 0);*/
        contadorEntradaEstadoFinal += 1; 
      }
      // Avanzar en línea recta durante 2.5 segundos
      if (millis() - tiempoInicioDetencionFinal < 1500) {
        if (!enGiro && 
          prioridadActual == PRIORIDAD_NORMAL) {
        centrarVehiculo();

        //Serial.println("normal");
          }
        
        // Debug cada segundo
       /* static unsigned long ultimoDebug = 0;
        if (millis() - ultimoDebug > 1000) {
          //("Avance final - Tiempo restante: ");
          //(2500 - (millis() - tiempoInicioAvanceFinal));
          //ln(" ms");
          ultimoDebug = millis();
        }*/
        
      } else {
        //ln("Avance final completado - Motor detenido");
        detenerRobot();
       // estadoActual = ESTADO_NORMAL; // Opcional: volver a estado normal
        
      }
      break;
      
  }  

    
  // MÁXIMA PRIORIDAD: Retroceso de emergencia (SOLO si NO está girando)
  if (prioridadActual == PRIORIDAD_RETROCESO && !giroEnProceso && !retrocesoOrientadoActivo && estadoActual !=ESTADO_DETENCION_FINAL){
    if (retrocesoPorEmergencia) {
      //procesarRetrocesoEmergencia();
    }
    return;
  }
  
  // ALTA PRIORIDAD: Retroceso post-giro
  if (procesarRetrocesoPostGiro()) {
    // El retroceso está activo, no ejecutar nada más
    return;
  }
    // Verificar obstáculos diagonales SOLO si NO está girando
    //if (!esquiveDiagonalActivo && !giroEnProceso && verificarObstaculoDiagonal()) {
      // Se activó esquive diagonal
    //}

    // Procesar esquive diagonal si está activo Y NO está girando
    if (esquiveDiagonalActivo && !giroEnProceso) {
      procesarEsquiveDiagonal();
    }
   
  // Mostrar el valor cada 300 ms
  if (millis() - lastYawPrint >= YAW_INTERVAL) {
        Serial.print("Yaw: ");
        //Serial.print(yawFiltrado);
        Serial.print(anguloZ);
        Serial.println(anguloZ);
        Serial.print("°  ");
        lastYawPrint = millis();
        Serial.println("Estado actual: " + obtenerNombreEstado(estadoActual));
        
    }

  delay(20);
}
