erchivox/Prometheus-Team-2025/(commit log)

2026-06-15 Enhance README with mechanical design and prototyping details
    Added detailed sections on mechanical structure, prototyping, and manufacturing for the autonomous vehicle project. Included design philosophy, CAD transition, and optimization strategies.
2026-06-15 Update prototype images in README.md
